Lab-FM-Project/master/Arduino_WebRadio_player/webradio_pic2.jpg

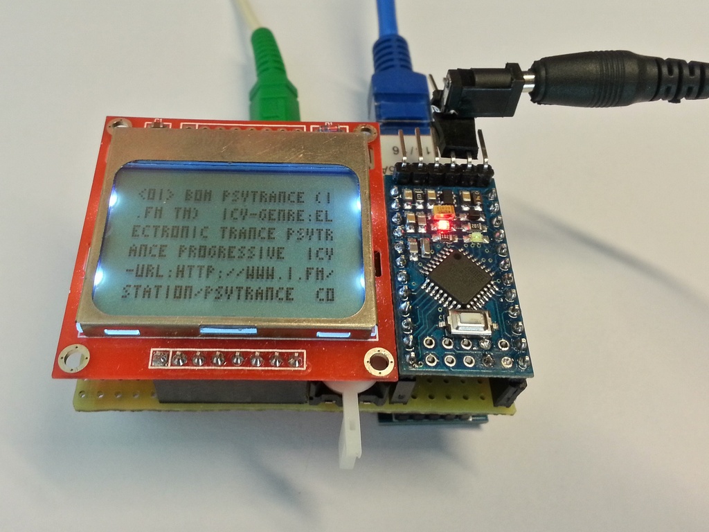
Arduino_WebRadio_player/webradio_pic2.jpg
