Lab-FM-Project/master/Arduino_WebRadio_player/webradio_pic1.jpg

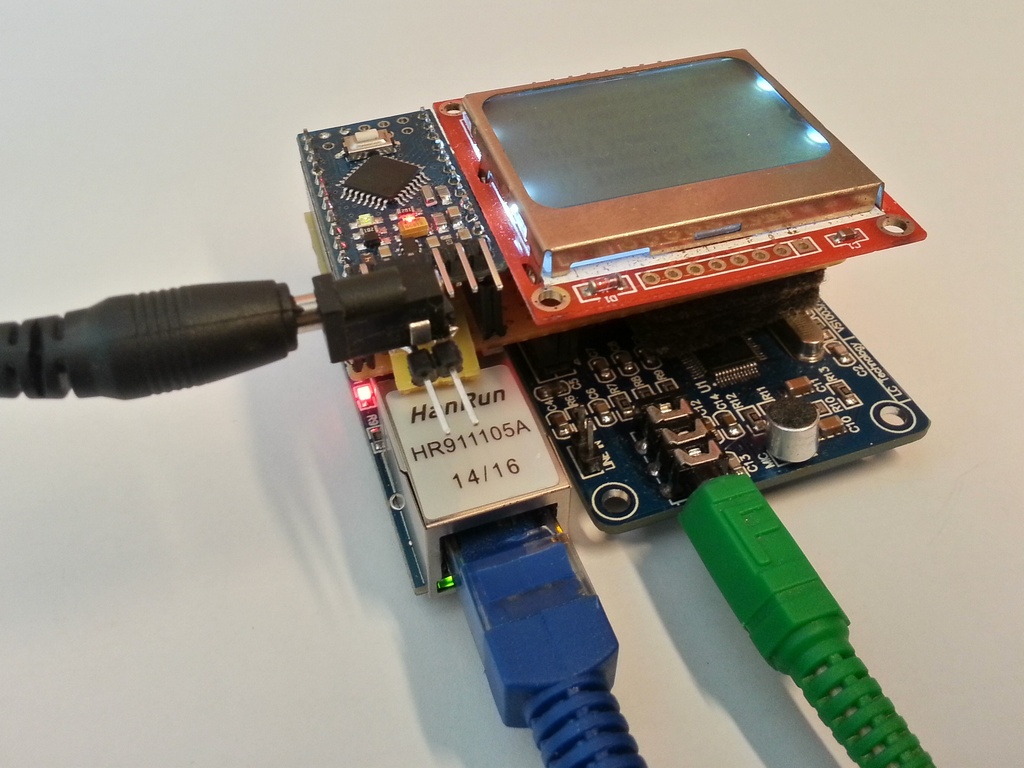
Arduino_WebRadio_player/webradio_pic1.jpg
