Lab-FM-Project/master/README.md

# master
FMProject master folder

Second year FM project. Based on the AR1010 FM chip. We got to play around with it and add any innovations. (Even if its only 10% of the mark!)
