Lab-FM-Project/master/Schematics/Circuit_Schematicv2.html

Partlist exported from /Users/user/Desktop/master/Schematics/Circuit_Schematicv2.sch at 24/03/2017 14:05

Part | Value | Device | Package | Description
3.3V | TPSPAD1-13 | TPSPAD1-13 | P1-13 | TEST PIN
24C64 | 24C64 | 24C64 | SOIC-8
ANT | | 2,15/1,0 | 2,15/1,0 | THROUGH-HOLE PAD
AR_PRG | | PINHD-1X7 | 1X07 | PIN HEADER
AUXJACK | | PINHD-1X5 | 1X05 | PIN HEADER
BAT- | | 2,15/1,0 | 2,15/1,0 | THROUGH-HOLE PAD
BAT_5V | | 2,15/1,0 | 2,15/1,0 | THROUGH-HOLE PAD
C1 | 10uF | 10UF-1210-50V-20% | 1210 | 10.0µF ceramic capacitors
C2 | 100nF | 10UF-1210-50V-20% | 1210 | 10.0µF ceramic capacitors
C3 | 10uF | 10UF-1210-50V-20% | 1210 | 10.0µF ceramic capacitors
C4 | 10uF | 10UF-1210-50V-20% | 1210 | 10.0µF ceramic capacitors
C5 | 10uF | 10UF-1210-50V-20% | 1210 | 10.0µF ceramic capacitors
C6 | 10uF | 10UF-1210-50V-20% | 1210 | 10.0µF ceramic capacitors
C7 | 100uF | 10UF-1210-50V-20% | 1210 | 10.0µF ceramic capacitors
C8 | 100uF | 10UF-1210-50V-20% | 1210 | 10.0µF ceramic capacitors
C9 | 100nF | 10UF-1210-50V-20% | 1210 | 10.0µF ceramic capacitors
C10 | 100nF | 10UF-1210-50V-20% | 1210 | 10.0µF ceramic capacitors
C11 | 10uF | 10UF-1210-50V-20% | 1210 | 10.0µF ceramic capacitors
C12 | 100nF | 10UF-1210-50V-20% | 1210 | 10.0µF ceramic capacitors
CLOCK | TPSPAD1-13 | TPSPAD1-13 | P1-13 | TEST PIN
D1 | BLUE | LED-BLUE1206 | LED-1206 | Blue SMD LED
DATA | TPSPAD1-13 | TPSPAD1-13 | P1-13 | TEST PIN
ESP_PRG | | PINHD-1X3 | 1X03 | PIN HEADER
FAV1 | | NMOSSOT223 | SOT223 | MOS FET
GND | TPSPAD1-13 | TPSPAD1-13 | P1-13 | TEST PIN
INT_PINS | | PINHD-1X2 | 1X02 | PIN HEADER
JP1 | | JP1E | JP1 | JUMPER
JP2 | | LCD16X2HEADER | LCD16X2HEADER | PIN HEADER
JP3 | | JP1E | JP1 | JUMPER
L-OUT | TPSPAD1-13 | TPSPAD1-13 | P1-13 | TEST PIN
MDL1 | | ESP8266-12EESP8266-ESP12E | ESP8266-ESP12E | ESP8266-12E with additional I/O and GPIO04/05 corrected
MUTE | | NMOSSOT223 | SOT223 | MOS FET
NEXT | | NMOSSOT223 | SOT223 | MOS FET
OUT1 | TPSPAD1-13 | TPSPAD1-13 | P1-13 | TEST PIN
PIC_PRG | | PINHD-1X6 | 1X06 | PIN HEADER
PREVIOUS | | NMOSSOT223 | SOT223 | MOS FET
Q2 | LE33CZ | LE33CZ | TO127P254X749-3 | VOLTAGE REGULATORS
R1 | 300 | 1OHM-0603-1/10W-1% | 0603 | 1Ω resistor
R2 | 10k | 10KOHM-0603-1/10W-1% | 0603 | 10kΩ resistor
R3 | 4.7 | 1OHM-0603-1/10W-1% | 0603 | 1Ω resistor
R4 | 4.7 | 1OHM-0603-1/10W-1% | 0603 | 1Ω resistor
R5 | 300 | 1OHM-0603-1/10W-1% | 0603 | 1Ω resistor
R6 | 300 | 1OHM-0603-1/10W-1% | 0603 | 1Ω resistor
R7 | 300 | 1OHM-0603-1/10W-1% | 0603 | 1Ω resistor
R8 | 300 | 1OHM-0603-1/10W-1% | 0603 | 1Ω resistor
R9 | 300 | 1OHM-0603-1/10W-1% | 0603 | 1Ω resistor
R10 | 10k | 10KOHM-0603-1/10W-1% | 0603 | 10kΩ resistor
R11 | 10k | 10KOHM-0603-1/10W-1% | 0603 | 10kΩ resistor
R12 | 10k | 10KOHM-0603-1/10W-1% | 0603 | 10kΩ resistor
R13 | 10k | 10KOHM-0603-1/10W-1% | 0603 | 10kΩ resistor
R14 | 10k | 10KOHM-0603-1/10W-1% | 0603 | 10kΩ resistor
R15 | 4.7k | 1OHM-0603-1/10W-1% | 0603 | 1Ω resistor
R16 | 10k | 10KOHM-0603-1/10W-1% | 0603 | 10kΩ resistor
R17 | 10k | 10KOHM-0603-1/10W-1% | 0603 | 10kΩ resistor
R18 | 4.7k | 1OHM-0603-1/10W-1% | 0603 | 1Ω resistor
S3 | RESET ESP | MOMENTARY-SWITCH-SPST-SMD-6.0X3.5MM | TACTILE_SWITCH_SMD_6.0X3.5MM | Momentary Switch (Pushbutton) - SPST
S4 | FAV1 | MOMENTARY-SWITCH-SPST-PTH-6.0MM-KIT | TACTILE_SWITCH_PTH_6.0MM_KIT | Momentary Switch (Pushbutton) - SPST
S5 | FAV2 | MOMENTARY-SWITCH-SPST-PTH-6.0MM-KIT | TACTILE_SWITCH_PTH_6.0MM_KIT | Momentary Switch (Pushbutton) - SPST
S6 | FAV3 | MOMENTARY-SWITCH-SPST-PTH-6.0MM-KIT | TACTILE_SWITCH_PTH_6.0MM_KIT | Momentary Switch (Pushbutton) - SPST
S7 | NEXT | MOMENTARY-SWITCH-SPST-PTH-6.0MM-KIT | TACTILE_SWITCH_PTH_6.0MM_KIT | Momentary Switch (Pushbutton) - SPST
S8 | PREVIOUS | MOMENTARY-SWITCH-SPST-PTH-6.0MM-KIT | TACTILE_SWITCH_PTH_6.0MM_KIT | Momentary Switch (Pushbutton) - SPST
S9 | VOLUP | MOMENTARY-SWITCH-SPST-PTH-6.0MM-KIT | TACTILE_SWITCH_PTH_6.0MM_KIT | Momentary Switch (Pushbutton) - SPST
S10 | VOLDOWN | MOMENTARY-SWITCH-SPST-PTH-6.0MM-KIT | TACTILE_SWITCH_PTH_6.0MM_KIT | Momentary Switch (Pushbutton) - SPST
S11 | MUTE | MOMENTARY-SWITCH-SPST-PTH-6.0MM-KIT | TACTILE_SWITCH_PTH_6.0MM_KIT | Momentary Switch (Pushbutton) - SPST
SPARE | | PINHD-1X8 | 1X08 | PIN HEADER
SWITCH1 | | 2,15/1,0 | 2,15/1,0 | THROUGH-HOLE PAD
SWITCH2 | | 2,15/1,0 | 2,15/1,0 | THROUGH-HOLE PAD
T7 | | NMOSSOT223 | SOT223 | MOS FET
U$1 | PIC18F6490-I/PT | PIC18F6490-I/PT | QFP50P1200X1200X120-64N | IC PIC MCU
U$2 | TDA2822M | TDA2822M | TDA2822M
U$4 | AR1010 | AR1010 | AR1010
VOLDOWN | | NMOSSOT223 | SOT223 | MOS FET
VOLUP | | NMOSSOT223 | SOT223 | MOS FET
VR1 | 10k | TRIMPOT-SMD-3MM-OPEN-1/10W-25% | TRIMPOT-SMD-TC33X | Trimming Potentiometer (Trimpot)
VR3 | 10k | TRIMPOT-SMD-3MM-OPEN-1/10W-25% | TRIMPOT-SMD-TC33X | Trimming Potentiometer (Trimpot)
VR4 | 4.7k | TRIMPOT-SMD-3MM-OPEN-1/10W-25% | TRIMPOT-SMD-TC33X | Trimming Potentiometer (Trimpot)
VR5 | 4.7k | TRIMPOT-SMD-3MM-OPEN-1/10W-25% | TRIMPOT-SMD-TC33X | Trimming Potentiometer (Trimpot)
