Lab-FM-Project/master/Arduino_WebRadio_player/WebRadio_schematic.GIF

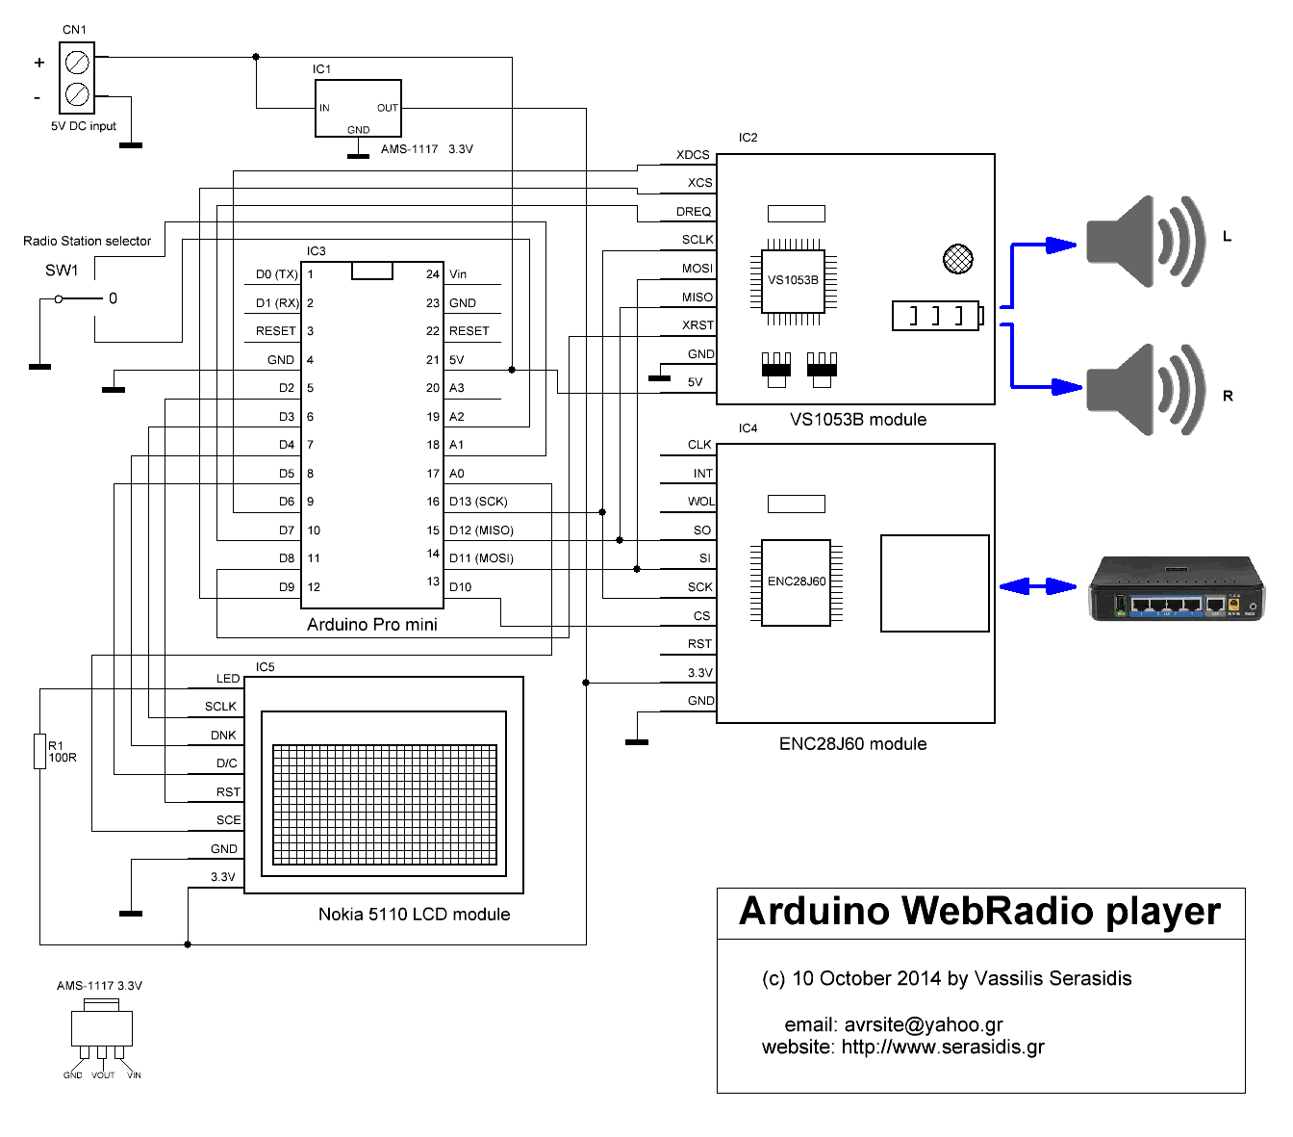
Arduino_WebRadio_player/WebRadio_schematic.GIF
