Lab-FM-Project/master/Schematics/amp&output.png

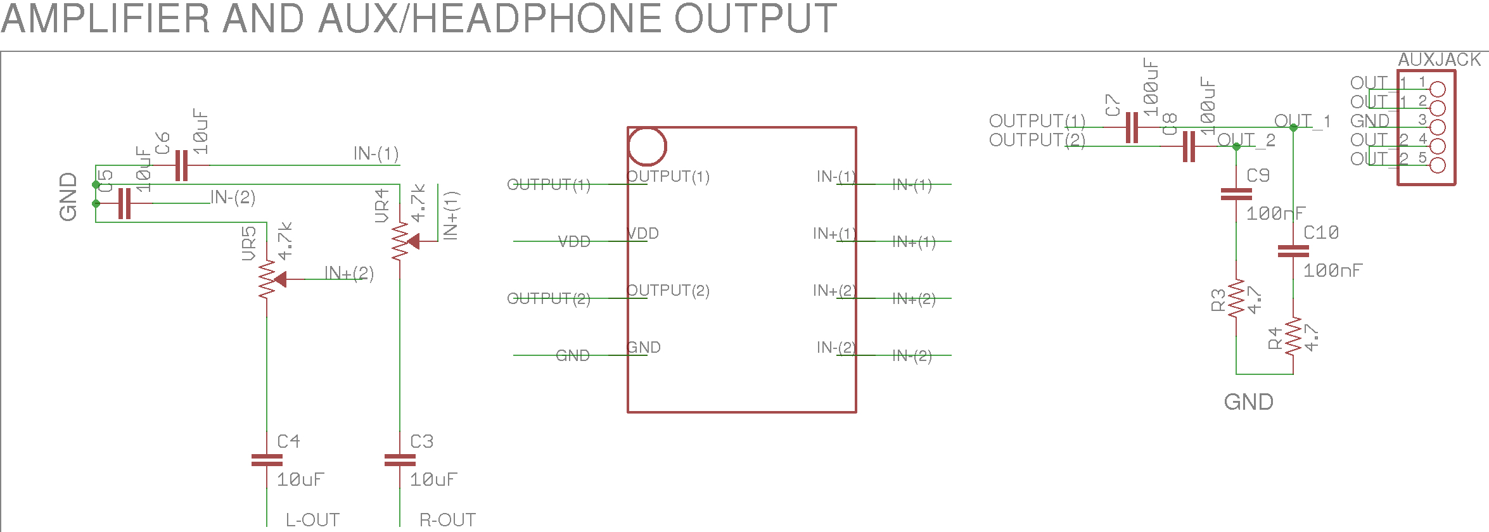
Schematics/amp&output.png
