Lab-FM-Project/master/Schematics/ar1010.png

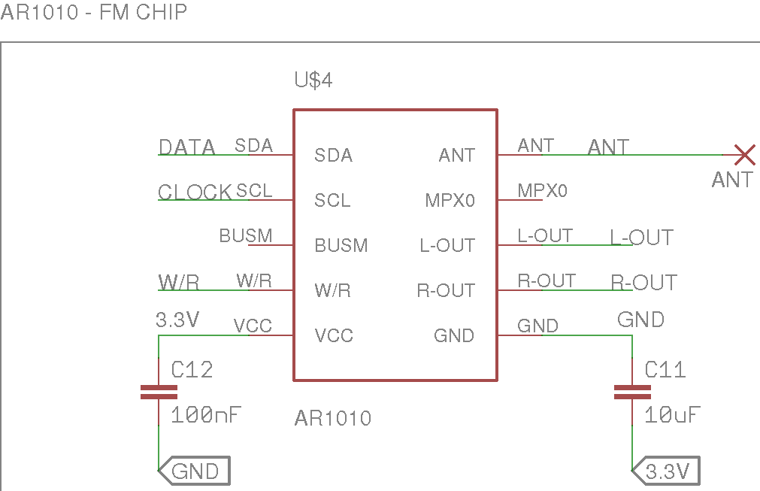
Schematics/ar1010.png
