Lab-FM-Project/master/Schematics/Basic_FM_Receiver_Schematic.png

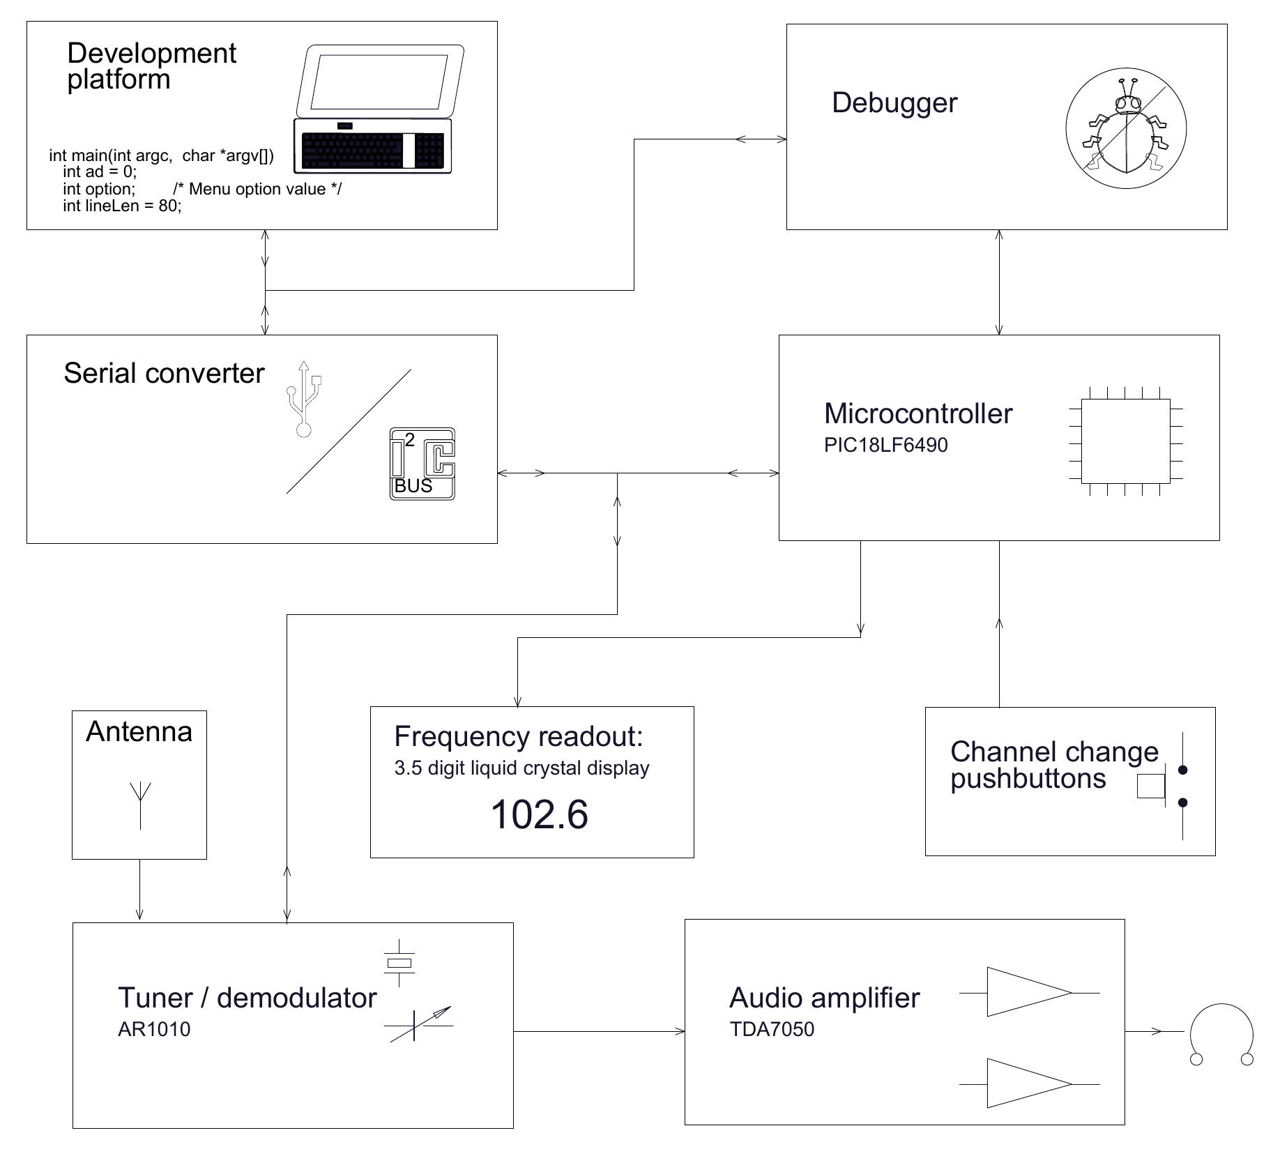
Schematics/Basic_FM_Receiver_Schematic.png
