Lab-FM-Project/master/Schematics/display.png

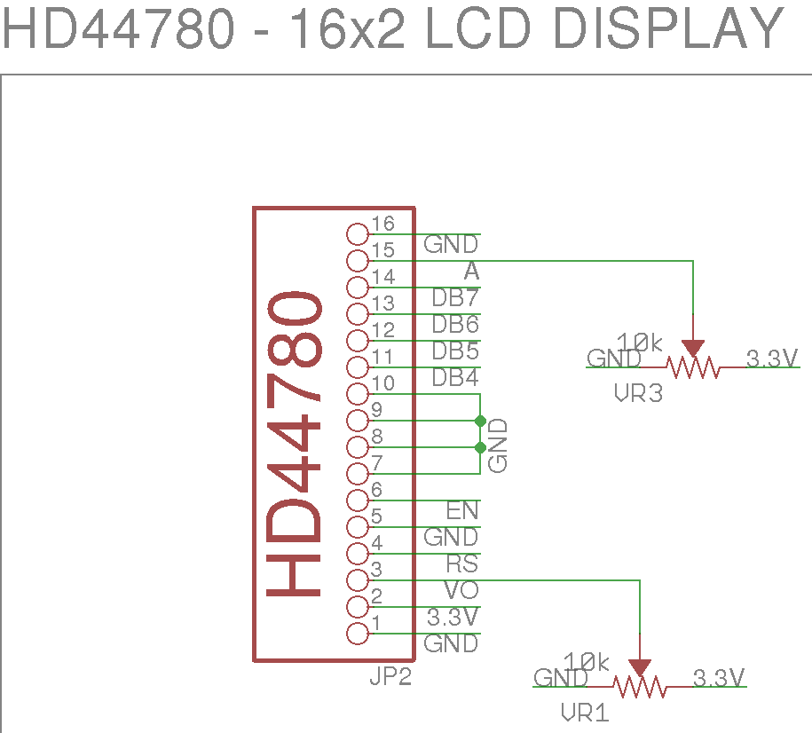
Schematics/display.png
