Lab-FM-Project/master/Schematics/eeprom.png

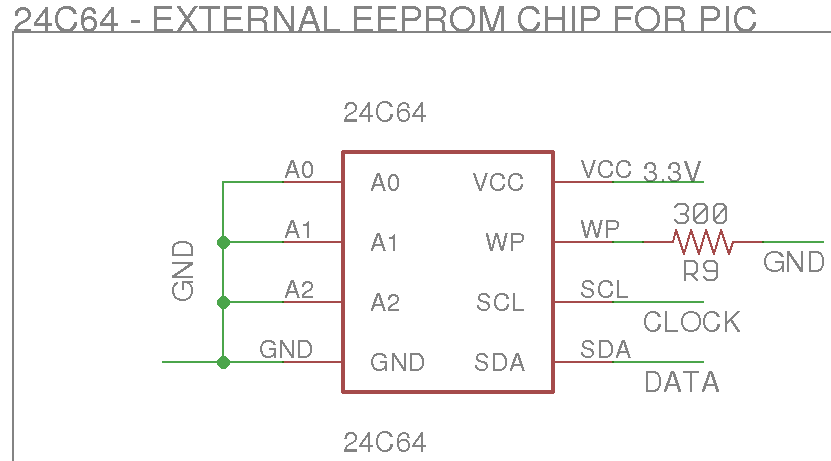
Schematics/eeprom.png
