Lab-FM-Project/master/Schematics/esp.png

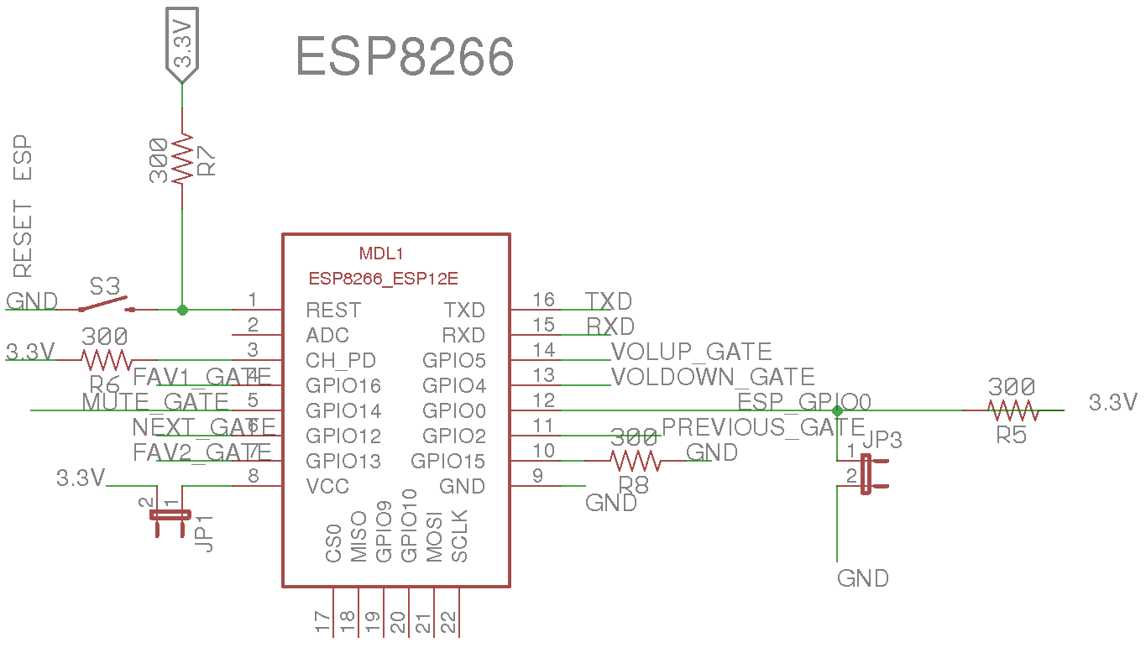
Schematics/esp.png
