Lab-FM-Project/master/Schematics/Final_PCB_Image.png

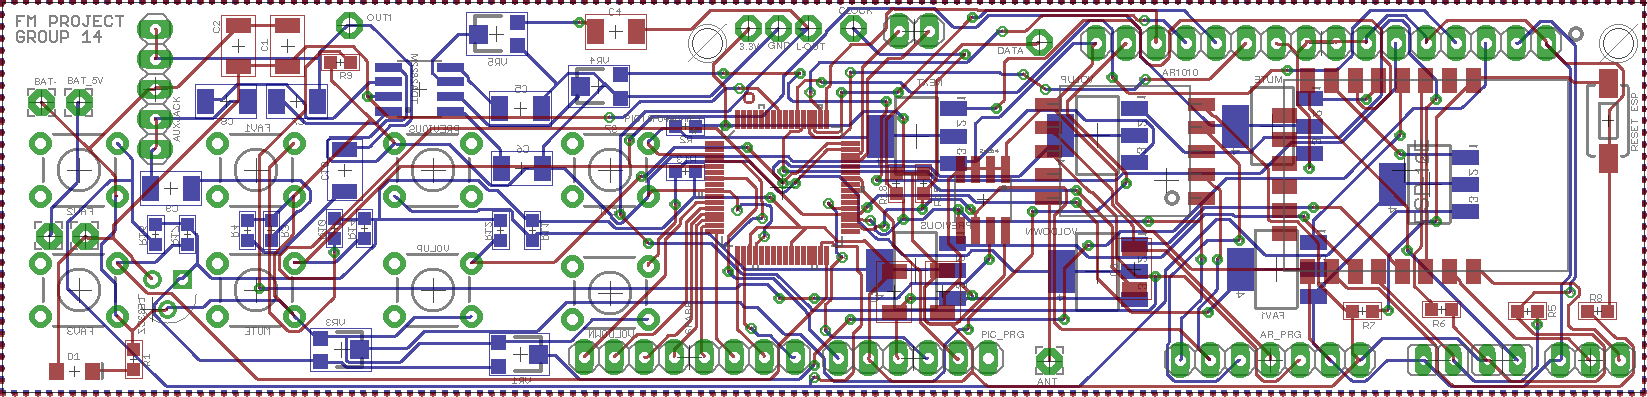
Schematics/Final_PCB_Image.png
