Lab-FM-Project/master/Schematics/Final_Schematic_Image.png

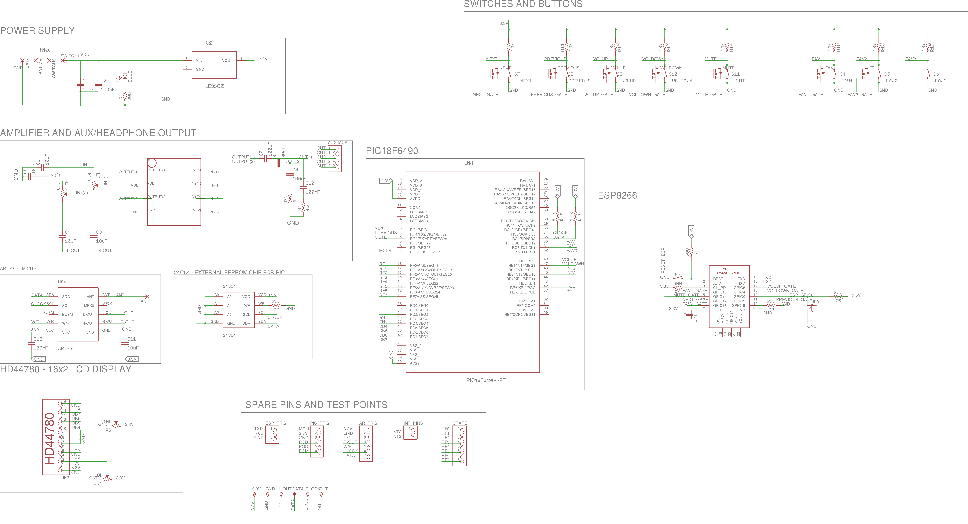
Schematics/Final_Schematic_Image.png
