Lab-FM-Project/master/Schematics/pic.png

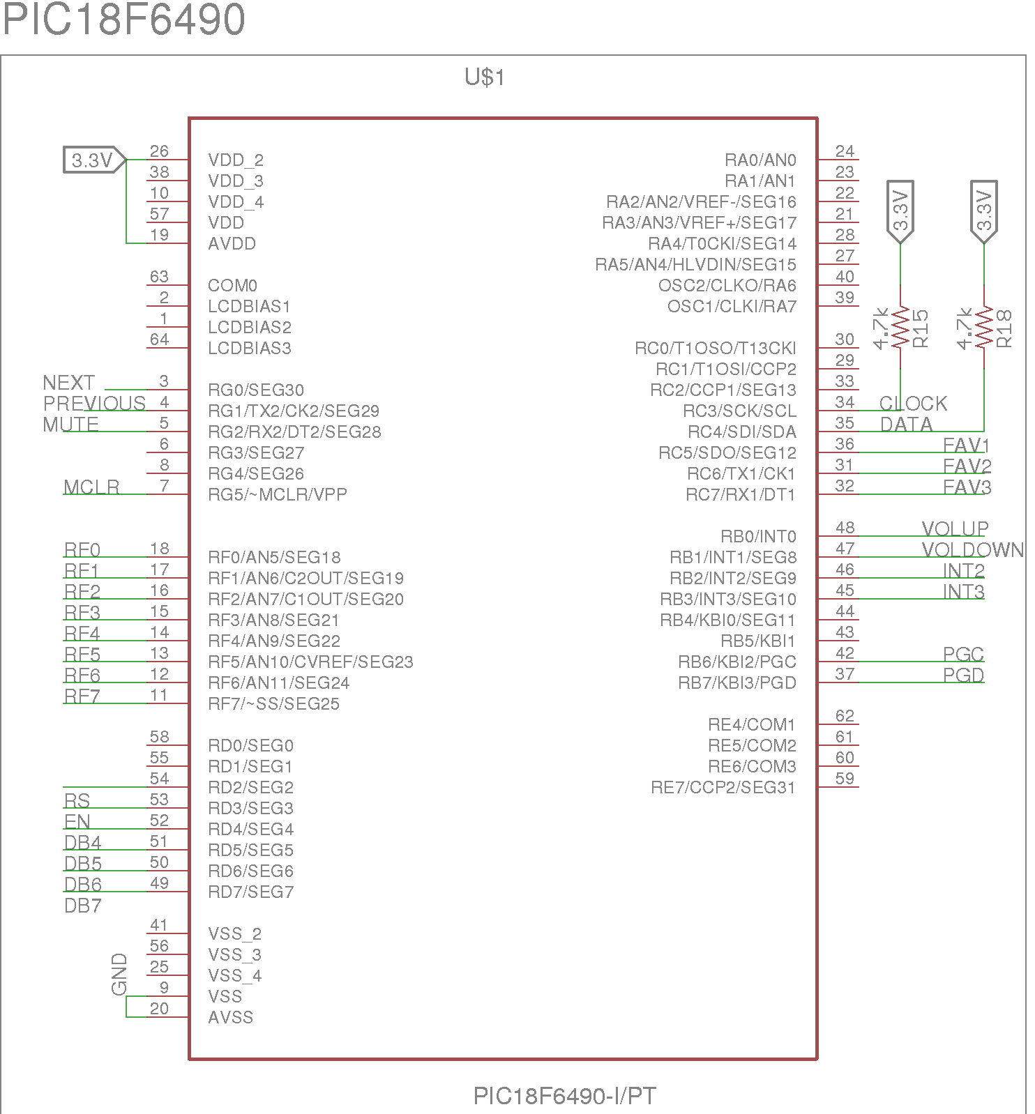
Schematics/pic.png
