Lab-FM-Project/master/Schematics/power_supply.png

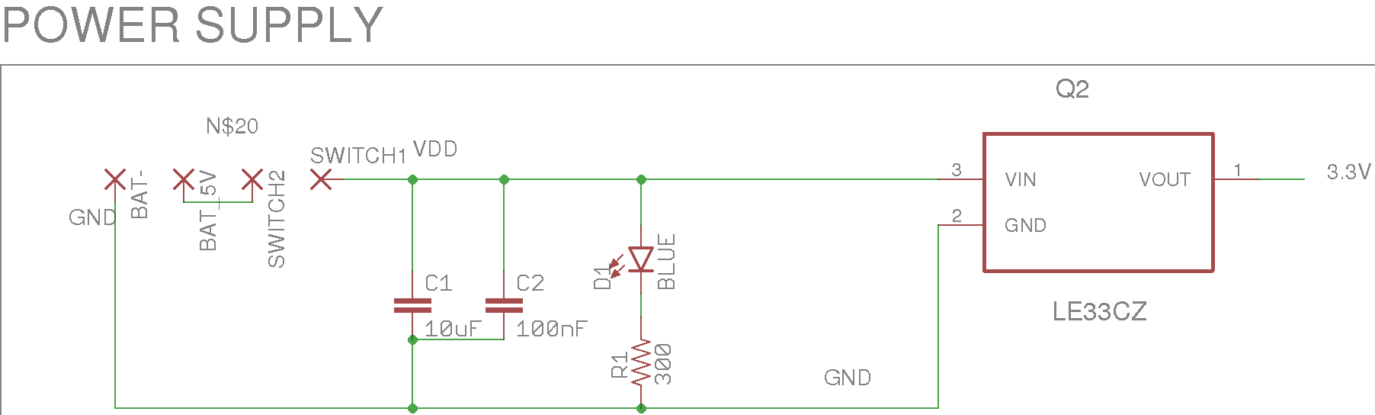
Schematics/power_supply.png
