Lab-FM-Project/master/Schematics/SchematicV0-2_14th-Feb.png

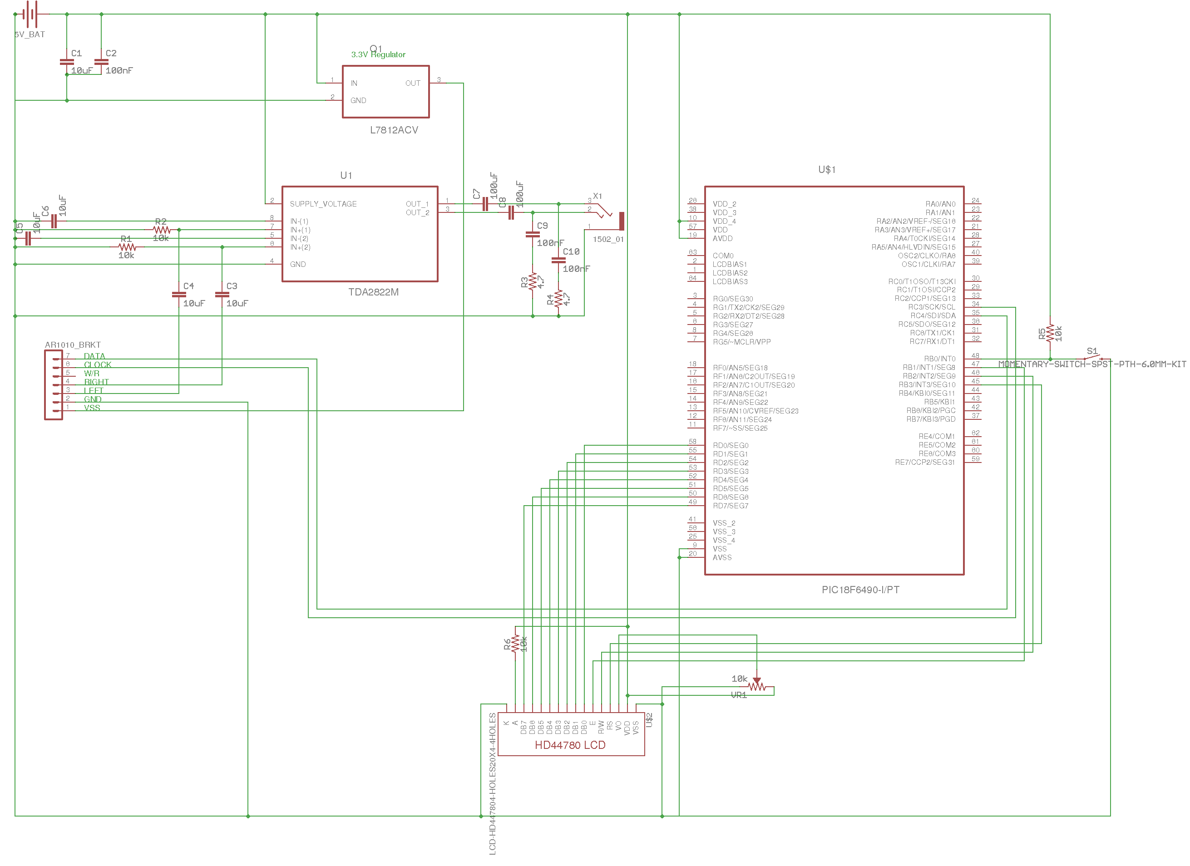
Schematics/SchematicV0-2_14th-Feb.png
