Lab-FM-Project/master/Schematics/switches_buttons.png

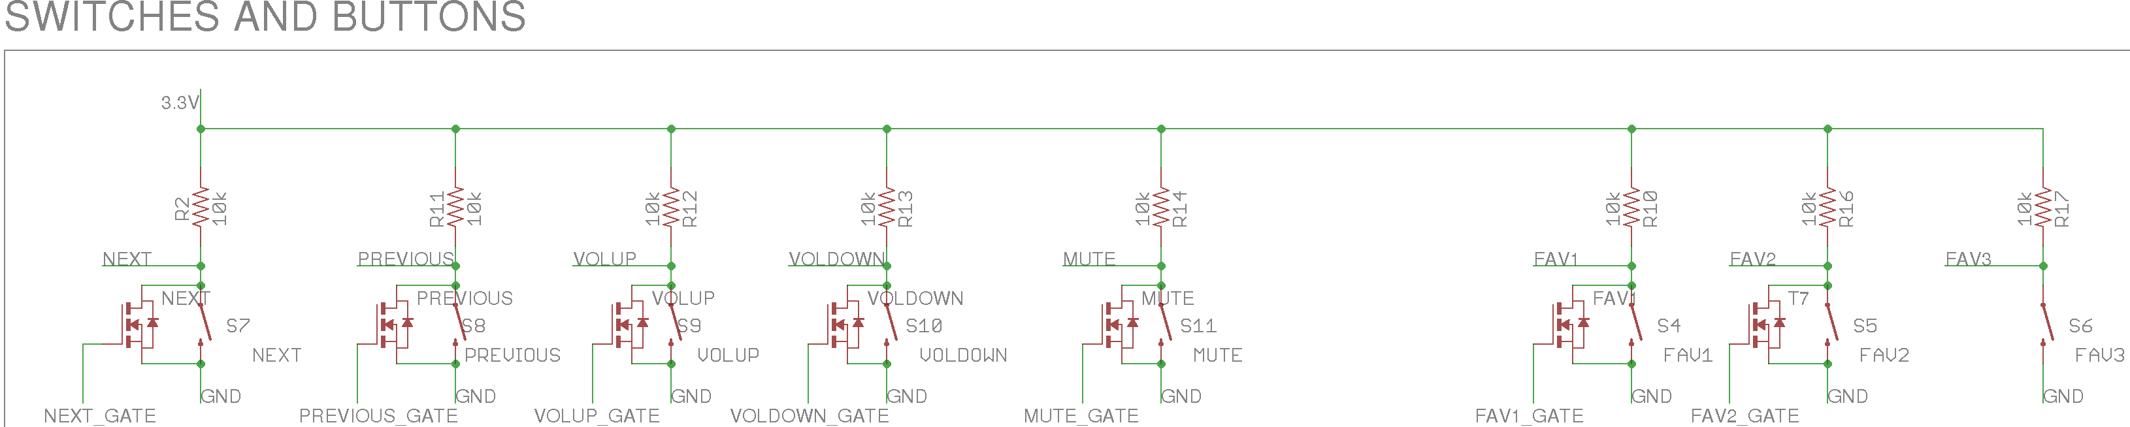
Schematics/switches_buttons.png
