Lab-FM-Project/master/Box files/main chasis.stl

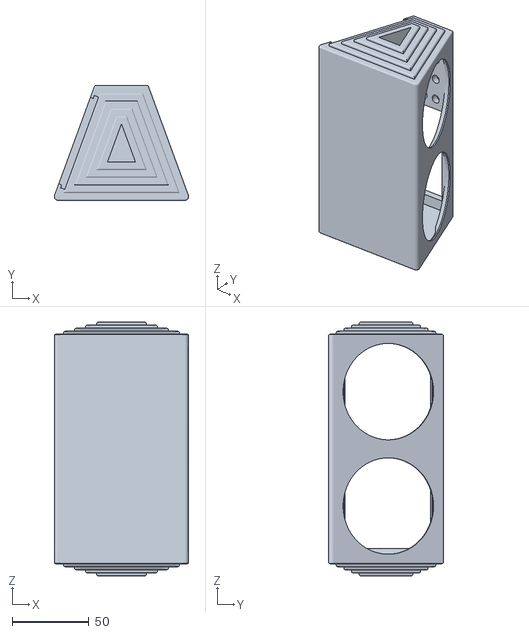
[picture p16: CAD file, 2017-02-28]
Box files/main chasis.stl
87.8 x 75.1 x 166.0
