Lab-FM-Project/master/Box files/FMBOXCHASIS.stl

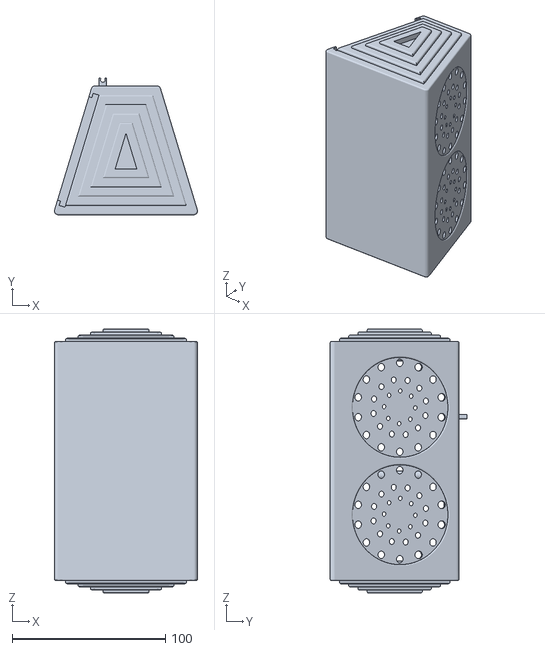
[picture p17: CAD file, 2017-03-03]
Box files/FMBOXCHASIS.stl
93.3 x 89.0 x 172.0
