Lab-FM-Project/master/Box files/fusion_to_PCB.dxf

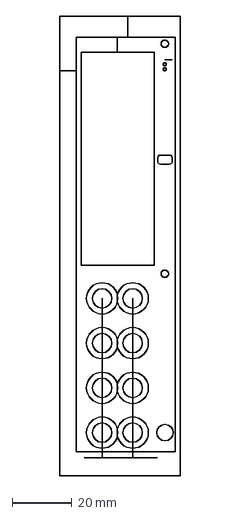
[picture p18: CAD file, 2017-03-03]
Box files/fusion_to_PCB.dxf
40.3 x 154.0 mm
