Lab-FM-Project/master/Box files/FMBOXLID.stl

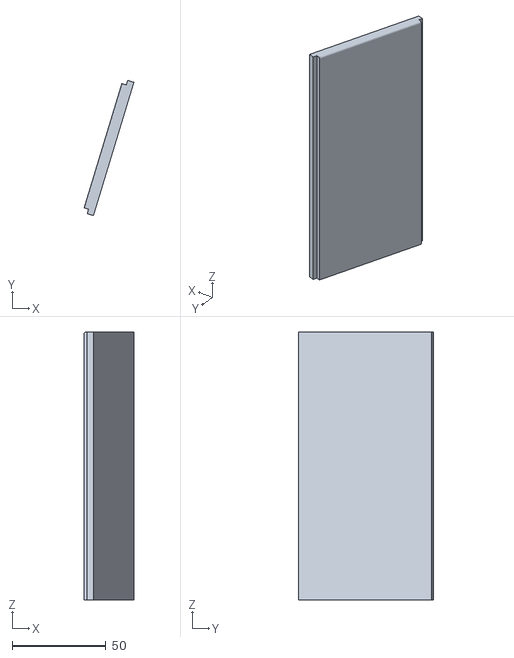
[picture p19: CAD file, 2017-03-03]
Box files/FMBOXLID.stl
26.6 x 72.1 x 143.0
