Lab-FM-Project/master/Box files/1.stl

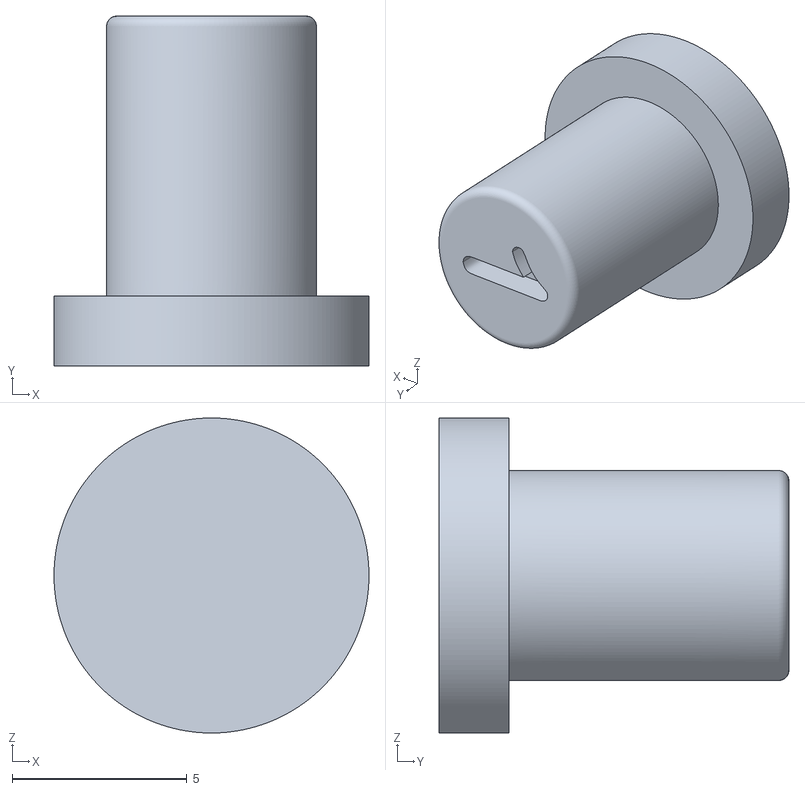
[picture p20: CAD file, 2017-02-28]
Box files/1.stl
9.00 x 10.0 x 9.00
