Lab-FM-Project/master/Box files/lid.stl

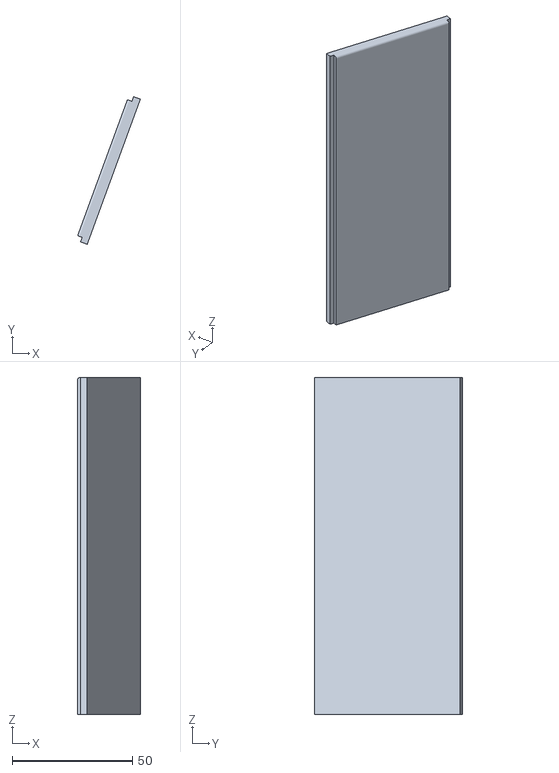
[picture p21: CAD file, 2017-02-28]
Box files/lid.stl
26.1 x 61.3 x 140.0
