Lab-FM-Project/master/Box files/3.stl

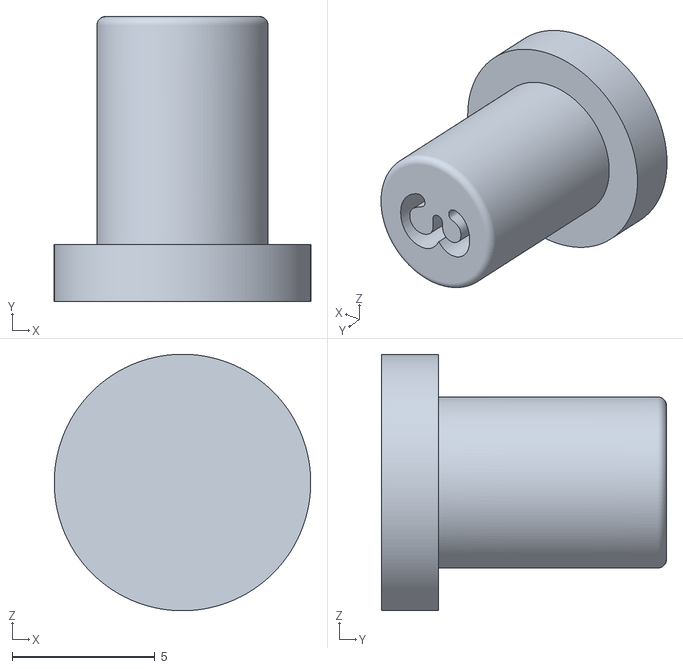
[picture p22: CAD file, 2017-02-28]
Box files/3.stl
9.00 x 10.0 x 9.00
