Lab-FM-Project/master/Box files/on switch.stl

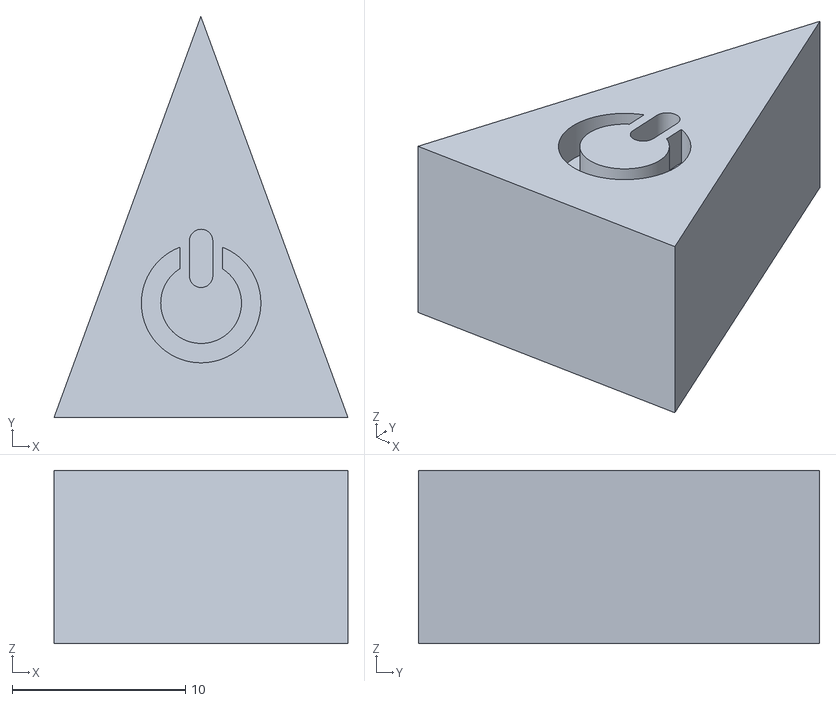
[picture p23: CAD file, 2017-02-28]
Box files/on switch.stl
17.0 x 23.2 x 10.0
