Lab-FM-Project/master/Box files/Prev.stl

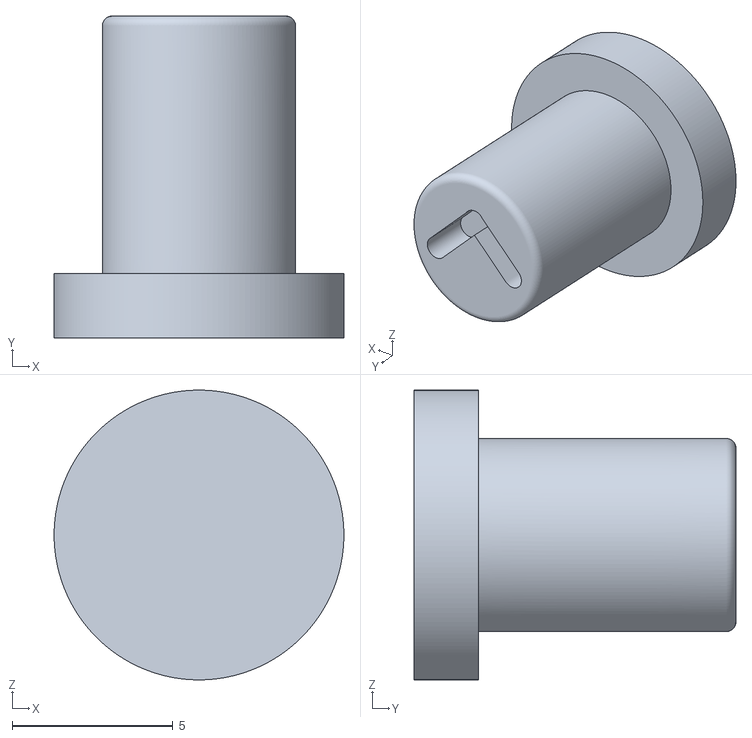
[picture p24: CAD file, 2017-02-28]
Box files/Prev.stl
9.00 x 10.0 x 9.00
