Lab-FM-Project/master/Box files/Vol DN.stl

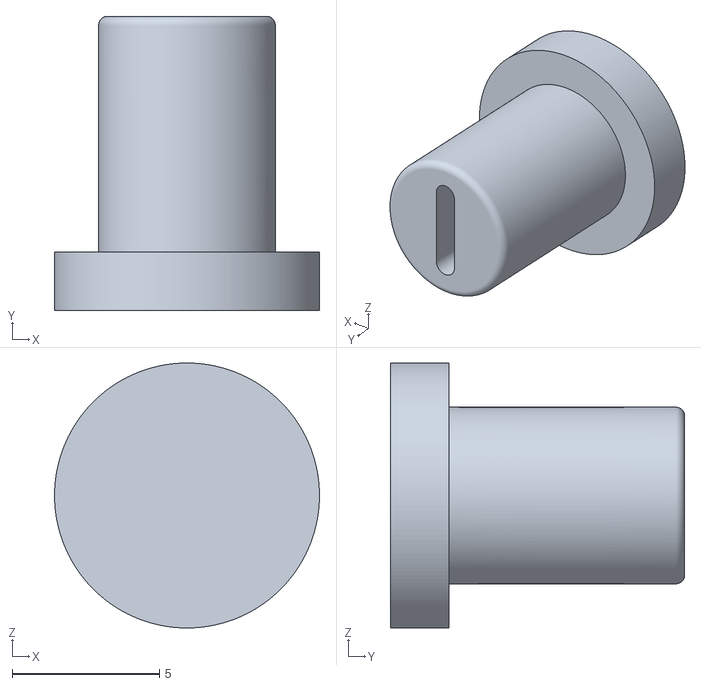
[picture p25: CAD file, 2017-02-28]
Box files/Vol DN.stl
9.00 x 10.0 x 9.00
