Lab-FM-Project/master/(list of files, cad)

Other CAD files:
Box files/Vol UP.stl
Box files/Mute.stl
Box files/Next.stl
Box files/2.stl
Box files/old/Next.stl
Box files/old/2.stl
Box files/old/Mute.stl
Box files/old/Vol UP.stl
