Lab-FM-Project/master/Schematics/spare_pins_test_points.png

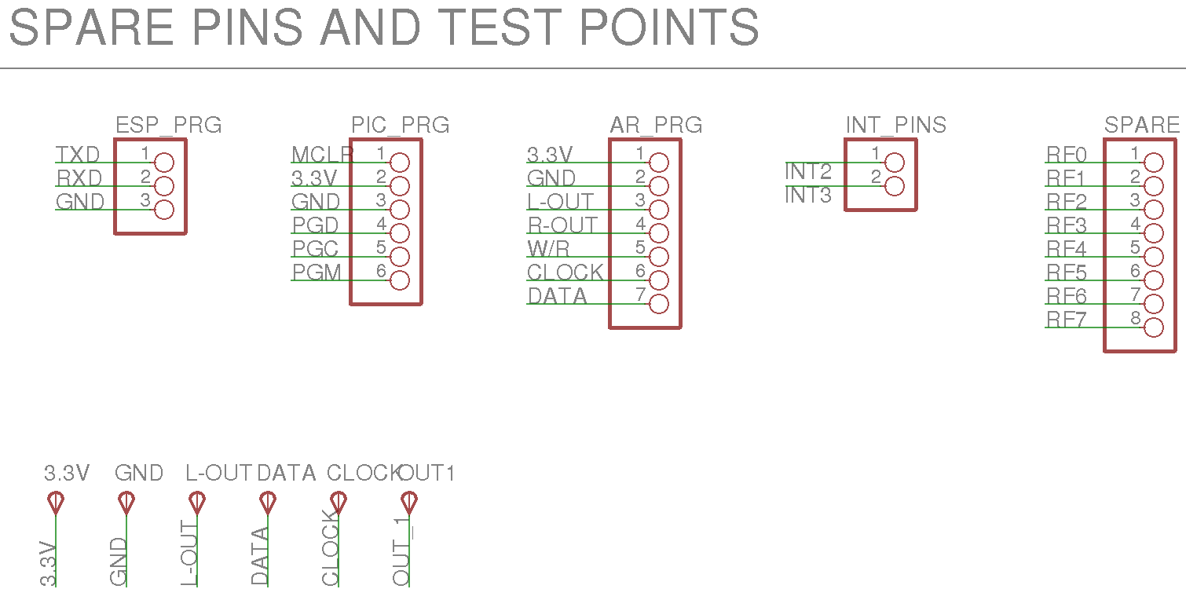
Schematics/spare_pins_test_points.png
