Lab-FM-Project/master/Schematics/Circuit_Schematicv2.brd

## EAGLE design Schematics/Circuit_Schematicv2.brd (2017-03-29)

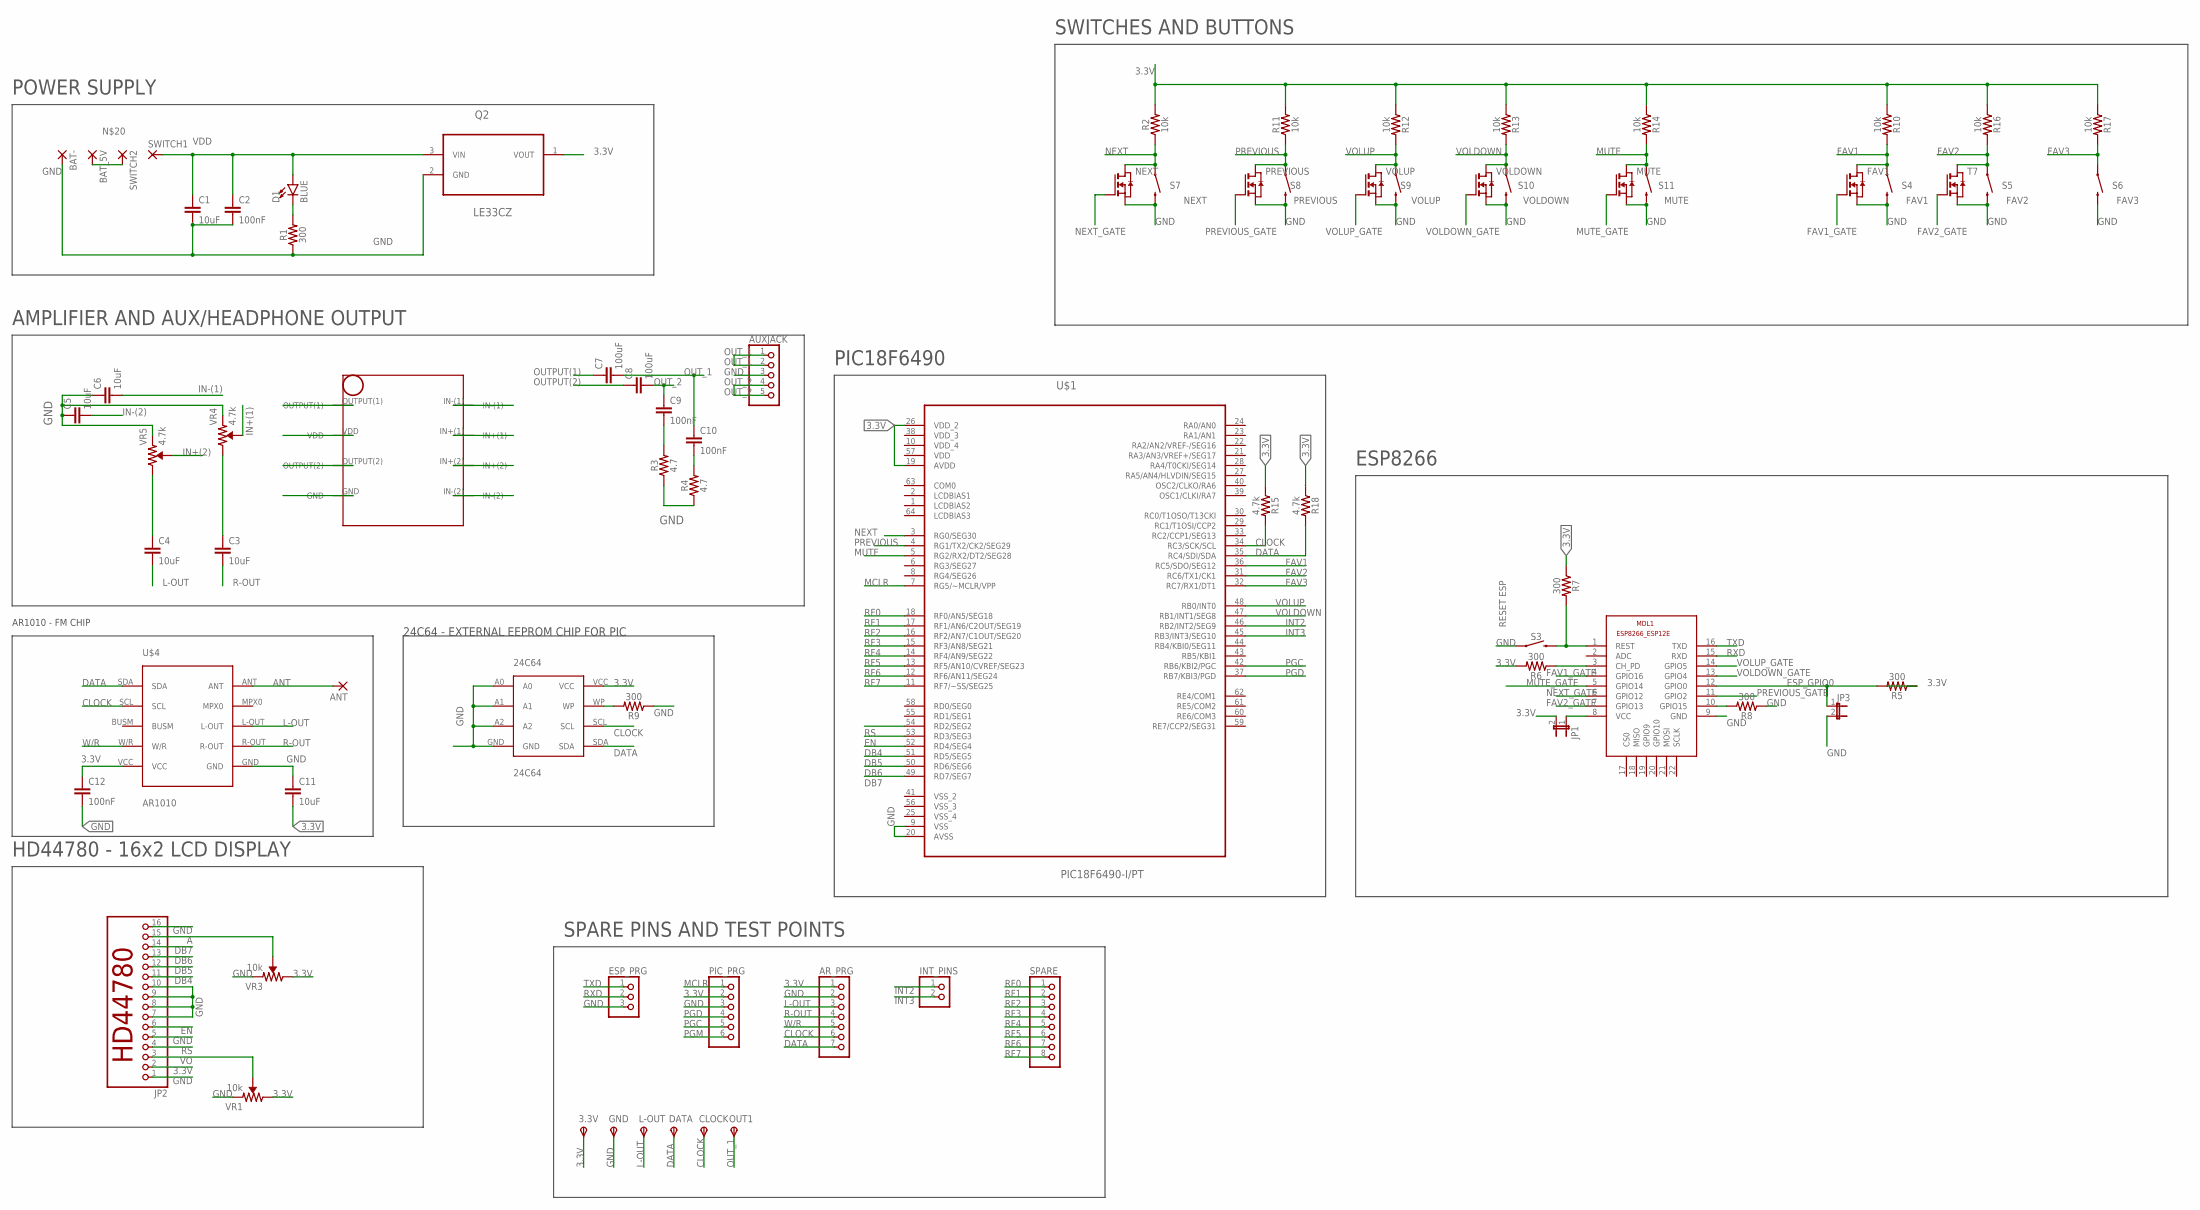
[picture p27: schematic Circuit_Schematicv2.sch]

Parts:
3.3V: TPSPAD1-13; P1-13
24C64: 24C64; SOIC-8
ANT: 2,15/1,0
AR_PRG: PINHD-1X7; 1X07
AUXJACK: PINHD-1X5; 1X05
BAT-: 2,15/1,0
BAT_5V: 2,15/1,0
C1, C3, C4, C5, C6, C11: 10uF; 1210
C2, C9, C10, C12: 100nF; 1210
C7, C8: 100uF; 1210
CLOCK: TPSPAD1-13; P1-13
D1: BLUE; LED-1206
DATA: TPSPAD1-13; P1-13
ESP_PRG: PINHD-1X3; 1X03
FAV1: NMOSSOT223; SOT223
GND: TPSPAD1-13; P1-13
INT_PINS: PINHD-1X2; 1X02
JP1, JP3: JP1E; JP1
JP2: LCD16X2HEADER
L-OUT: TPSPAD1-13; P1-13
MDL1: ESP8266-12EESP8266-ESP12E; ESP8266-ESP12E
MUTE: NMOSSOT223; SOT223
NEXT: NMOSSOT223; SOT223
OUT1: TPSPAD1-13; P1-13
PIC_PRG: PINHD-1X6; 1X06
PREVIOUS: NMOSSOT223; SOT223
Q2: LE33CZ; TO127P254X749-3
R1, R5, R6, R7, R8, R9: 300; 0603
R2, R10, R11, R12, R13, R14, R16, R17: 10k; 0603
R3, R4: 4.7; 0603
R15, R18: 4.7k; 0603
S3: RESET ESP; TACTILE_SWITCH_SMD_6.0X3.5MM
S4: FAV1; TACTILE_SWITCH_PTH_6.0MM_KIT
S5: FAV2; TACTILE_SWITCH_PTH_6.0MM_KIT
S6: FAV3; TACTILE_SWITCH_PTH_6.0MM_KIT
S7: NEXT; TACTILE_SWITCH_PTH_6.0MM_KIT
S8: PREVIOUS; TACTILE_SWITCH_PTH_6.0MM_KIT
S9: VOLUP; TACTILE_SWITCH_PTH_6.0MM_KIT
S10: VOLDOWN; TACTILE_SWITCH_PTH_6.0MM_KIT
S11: MUTE; TACTILE_SWITCH_PTH_6.0MM_KIT
SPARE: PINHD-1X8; 1X08
SWITCH1, SWITCH2: 2,15/1,0
T7: NMOSSOT223; SOT223
U$1: PIC18F6490-I/PT; QFP50P1200X1200X120-64N
U$2: TDA2822M
U$4: AR1010
VOLDOWN: NMOSSOT223; SOT223
VOLUP: NMOSSOT223; SOT223
VR1, VR3: 10k; TRIMPOT-SMD-TC33X
VR4, VR5: 4.7k; TRIMPOT-SMD-TC33X

Connections:
3.3V: 3.3V.TP, 24C64.VCC, AR_PRG.1, C11.2, C12.1, JP1.2, JP2.2, PIC_PRG.2, Q2.1 (VOUT), R2.2, R5.1, R6.2, R7.1, R10.1, R11.2, R12.1, R13.1, R14.1, R15.1, R16.1, R17.1, R18.1, U$1.19 (AVDD), U$1.26 (VDD_2), U$4.VCC, VR1.1 (CW), VR3.1 (CW)
A: JP2.15, VR3.2 (WIPER)
ANT: ANT.1, U$4.ANT
CH_PD: MDL1.3 (CH_PD), R6.1
CLOCK: 24C64.SCL, AR_PRG.6, CLOCK.TP, R15.2, U$1.34 (RC3/SCK/SCL), U$4.SCL
DATA: 24C64.SDA, AR_PRG.7, DATA.TP, R18.2, U$1.35 (RC4/SDI/SDA), U$4.SDA
DB4: JP2.11, U$1.52 (RD4/SEG4)
DB5: JP2.12, U$1.51 (RD5/SEG5)
DB6: JP2.13, U$1.50 (RD6/SEG6)
DB7: JP2.14, U$1.49 (RD7/SEG7)
EN: JP2.6, U$1.53 (RD3/SEG3)
ESP_GPIO0: JP3.1, MDL1.12 (GPIO0), R5.2
ESP_VCC: JP1.1, MDL1.8 (VCC)
FAV1: FAV1.2 (D), FAV1.4 (D), R10.2, S4.1, U$1.36 (RC5/SDO/SEG12)
FAV1_GATE: FAV1.1 (G), MDL1.4 (GPIO16)
FAV2: R16.2, S5.1, T7.2 (D), T7.4 (D), U$1.31 (RC6/TX1/CK1)
FAV2_GATE: MDL1.7 (GPIO13), T7.1 (G)
FAV3: R17.2, S6.1, U$1.32 (RC7/RX1/DT1)
GND: 24C64.A0, 24C64.A1, 24C64.A2, 24C64.GND, AR_PRG.2, AUXJACK.3, BAT-.1, C1.2, C2.2, C5.1, C6.1, C11.1, C12.2, ESP_PRG.3, FAV1.3 (S), GND.TP, JP2.1, JP2.5, JP2.7, JP2.8, JP2.9, JP2.10, JP2.16, JP3.2, MDL1.9 (GND), MUTE.3 (S), NEXT.3 (S), PIC_PRG.3, PREVIOUS.3 (S), Q2.2 (GND), R1.1, R3.1, R4.1, R8.1, R9.1, S3.1, S4.3 (2), S5.3 (2), S6.3 (2), S7.3 (2), S8.3 (2), S9.3 (2), S10.3 (2), S11.3 (2), T7.3 (S), U$1.9 (VSS), U$1.20 (AVSS), U$2.GND, U$4.GND, VOLDOWN.3 (S), VOLUP.3 (S), VR1.3 (CCW), VR3.3 (CCW), VR4.3 (CCW), VR5.3 (CCW)
IN+(1): U$2.IN+(1), VR4.2 (WIPER)
IN+(2): U$2.IN+(2), VR5.2 (WIPER)
IN-(1): C6.2, U$2.IN-(1)
IN-(2): C5.2, U$2.IN-(2)
INT2: INT_PINS.1, U$1.46 (RB2/INT2/SEG9)
INT3: INT_PINS.2, U$1.45 (RB3/INT3/SEG10)
L-OUT: AR_PRG.3, C4.2, L-OUT.TP, U$4.L-OUT
MCLR: PIC_PRG.1, U$1.7 (RG5/~MCLR/VPP)
MUTE: MUTE.2 (D), MUTE.4 (D), R14.2, S11.1, U$1.5 (RG2/RX2/DT2/SEG28)
MUTE_GATE: MDL1.5 (GPIO14), MUTE.1 (G)
unnamed: C10.2, R4.2
unnamed: 24C64.WP, R9.2
unnamed: C4.1, VR5.1 (CW)
unnamed: C3.1, VR4.1 (CW)
unnamed: C9.2, R3.2
unnamed: D1.C, R1.2
unnamed: BAT_5V.1, SWITCH2.1
unnamed: MDL1.10 (GPIO15), R8.2
NEXT: NEXT.2 (D), NEXT.4 (D), R2.1, S7.1, U$1.3 (RG0/SEG30)
NEXT_GATE: MDL1.6 (GPIO12), NEXT.1 (G)
OUTPUT(1): C7.1, U$2.OUTPUT(1)
OUTPUT(2): C8.1, U$2.OUTPUT(2)
OUT_1: AUXJACK.1, AUXJACK.2, C7.2, C10.1, OUT1.TP
OUT_2: AUXJACK.4, AUXJACK.5, C8.2, C9.1
PGC: PIC_PRG.5, U$1.42 (RB6/KBI2/PGC)
PGD: PIC_PRG.4, U$1.37 (RB7/KBI3/PGD)
PGM: PIC_PRG.6
PREVIOUS: PREVIOUS.2 (D), PREVIOUS.4 (D), R11.1, S8.1, U$1.4 (RG1/TX2/CK2/SEG29)
PREVIOUS_GATE: MDL1.11 (GPIO2), PREVIOUS.1 (G)
R-OUT: AR_PRG.4, C3.2, U$4.R-OUT
REST: MDL1.1 (REST), R7.2, S3.2
RF0: SPARE.1, U$1.18 (RF0/AN5/SEG18)
RF1: SPARE.2, U$1.17 (RF1/AN6/C2OUT/SEG19)
RF2: SPARE.3, U$1.16 (RF2/AN7/C1OUT/SEG20)
RF3: SPARE.4, U$1.15 (RF3/AN8/SEG21)
RF4: SPARE.5, U$1.14 (RF4/AN9/SEG22)
RF5: SPARE.6, U$1.13 (RF5/AN10/CVREF/SEG23)
RF6: SPARE.7, U$1.12 (RF6/AN11/SEG24)
RF7: SPARE.8, U$1.11 (RF7/~SS/SEG25)
RS: JP2.4, U$1.54 (RD2/SEG2)
RXD: ESP_PRG.2, MDL1.15 (RXD)
TXD: ESP_PRG.1, MDL1.16 (TXD)
VDD: C1.1, C2.1, D1.A, Q2.3 (VIN), SWITCH1.1, U$1.57 (VDD), U$2.VDD
VDD_3: U$1.38 (VDD_3)
VDD_4: U$1.10 (VDD_4)
VO: JP2.3, VR1.2 (WIPER)
VOLDOWN: R13.2, S10.1, U$1.47 (RB1/INT1/SEG8), VOLDOWN.2 (D), VOLDOWN.4 (D)
VOLDOWN_GATE: MDL1.13 (GPIO4), VOLDOWN.1 (G)
VOLUP: R12.2, S9.1, U$1.48 (RB0/INT0), VOLUP.2 (D), VOLUP.4 (D)
VOLUP_GATE: MDL1.14 (GPIO5), VOLUP.1 (G)
VSS_2: U$1.41 (VSS_2)
VSS_3: U$1.56 (VSS_3)
VSS_4: U$1.25 (VSS_4)
W/R: AR_PRG.5, U$4.W/R

Notes on the sheet:
POWER SUPPLY
AMPLIFIER AND AUX/HEADPHONE OUTPUT
SWITCHES AND BUTTONS
AR1010 - FM CHIP
HD44780 - 16x2 LCD DISPLAY
ESP8266
24C64 - EXTERNAL EEPROM CHIP FOR PIC
PIC18F6490
SPARE PINS AND TEST POINTS

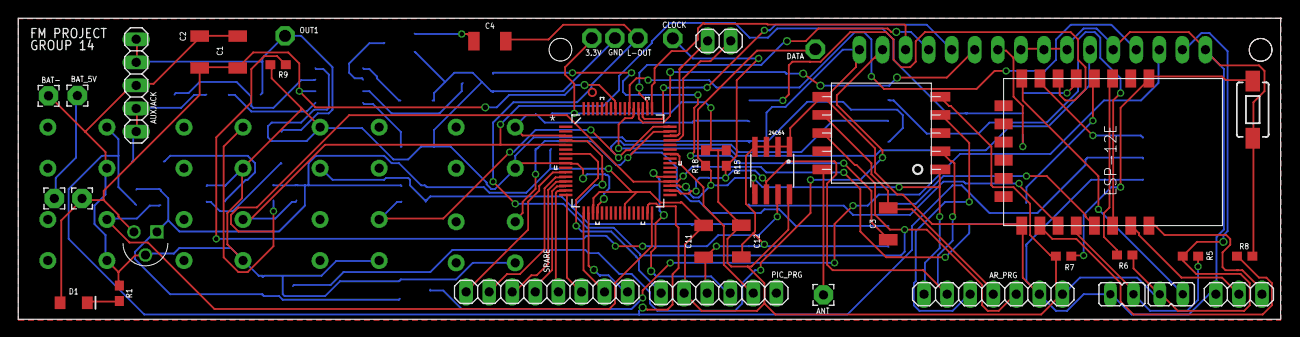
[picture p28: board Circuit_Schematicv2.brd from above]

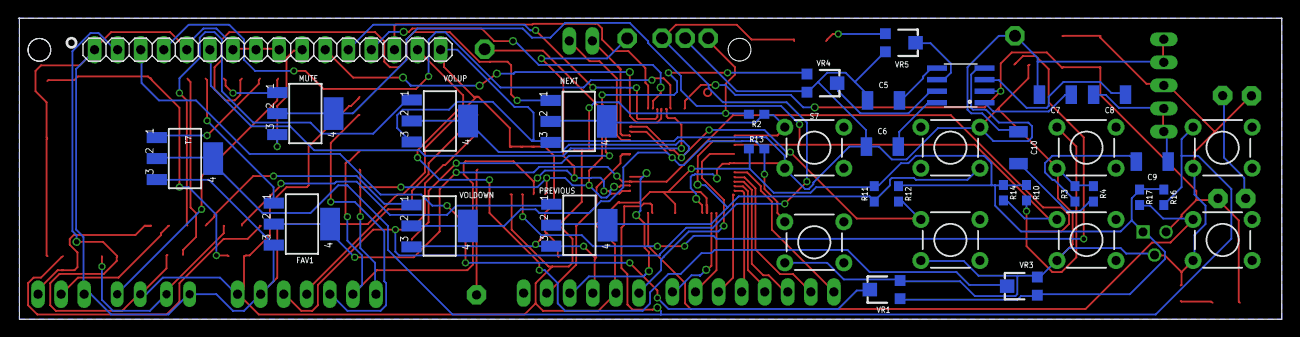
[picture p29: board Circuit_Schematicv2.brd from below]

Board: 2 copper layers, 139.0 x 33.1 mm, 77 parts (37 on the bottom side), 67 nets.
