Lab-FM-Project/master/LCD.X/lcd.h

//LCD Functions Developed by electroSome


void Lcd_Port(char a)
{
	if(a & 1)
		D4 = 1;
	else
		D4 = 0;

	if(a & 2)
		D5 = 1;
	else
		D5 = 0;

	if(a & 4)
		D6 = 1;
	else
		D6 = 0;

	if(a & 8)
		D7 = 1;
	else
		D7 = 0;
}
void Lcd_Cmd(char a)
{
	RS = 0;             // => RS = 0
	Lcd_Port(a);
	EN  = 1;             // => E = 1
        __delay_ms(4);
        EN  = 0;             // => E = 0
}

Lcd_Clear()
{
	Lcd_Cmd(0);
	Lcd_Cmd(1);
}

void Lcd_Set_Cursor(char a, char b)
{
	char temp,z,y;
	if(a == 1)
	{
	  temp = 0x80 + b - 1;
		z = temp>>4;
		y = temp & 0x0F;
		Lcd_Cmd(z);
		Lcd_Cmd(y);
	}
	else if(a == 2)
	{
		temp = 0xC0 + b - 1;
		z = temp>>4;
		y = temp & 0x0F;
		Lcd_Cmd(z);
		Lcd_Cmd(y);
	}
}

void Lcd_Init()
{
  Lcd_Port(0x00);
   __delay_ms(20);
  Lcd_Cmd(0x03);
	__delay_ms(5);
  Lcd_Cmd(0x03);
	__delay_ms(11);
  Lcd_Cmd(0x03);
  /////////////////////////////////////////////////////
  Lcd_Cmd(0x02);
  Lcd_Cmd(0x02);
  Lcd_Cmd(0x08);
  Lcd_Cmd(0x00);
  Lcd_Cmd(0x0C);
  Lcd_Cmd(0x00);
  Lcd_Cmd(0x06);
}

void Lcd_Write_Char(char a)
{
   char temp,y;
   temp = a&0x0F;
   y = a&0xF0;
   RS = 1;             // => RS = 1
   Lcd_Port(y>>4);             //Data transfer
   EN = 1;
   __delay_us(40);
   EN = 0;
   Lcd_Port(temp);
   EN = 1;
   __delay_us(40);
   EN = 0;
}

void Lcd_Write_String(char *a)
{
	int i;
	for(i=0;a[i]!='\0';i++)
	   Lcd_Write_Char(a[i]);
}

void Lcd_Shift_Right()
{
	Lcd_Cmd(0x01);
	Lcd_Cmd(0x0C);
}

void Lcd_Shift_Left()
{
	Lcd_Cmd(0x01);
	Lcd_Cmd(0x08);
}


void homescreen(float freq)
{
	char output[50];
    snprintf(output, 50, "%f", freq);

printf("%s", output);
    Lcd_Clear();
    Lcd_Set_Cursor(1,1);
    Lcd_Write_String(c);
    
    Lcd_Set_Cursor(2,1);
    
   Lcd_Write_String("89.5");
   Lcd_Write_String("MHZ");
}
=======
/**
    Header File for Module lcd.c

  Company:
    Microchip Technology Inc.

  File Name:
    lcd.h

  Summary:
    This file contains the function prototypes for LCD.

  Description:
    This file contains service prototype definition for LCD access on the PicDem 2 Plus demo board.
*/

/*
Copyright (c) 2013 - 2014 released Microchip Technology Inc.  All rights reserved.

Microchip licenses to you the right to use, modify, copy and distribute
Software only when embedded on a Microchip microcontroller or digital signal
controller that is integrated into your product or third party product
(pursuant to the sublicense terms in the accompanying license agreement).

You should refer to the license agreement accompanying this Software for
additional information regarding your rights and obligations.

SOFTWARE AND DOCUMENTATION ARE PROVIDED "AS IS" WITHOUT WARRANTY OF ANY KIND,
EITHER EXPRESS OR IMPLIED, INCLUDING WITHOUT LIMITATION, ANY WARRANTY OF
MERCHANTABILITY, TITLE, NON-INFRINGEMENT AND FITNESS FOR A PARTICULAR PURPOSE.
IN NO EVENT SHALL MICROCHIP OR ITS LICENSORS BE LIABLE OR OBLIGATED UNDER
CONTRACT, NEGLIGENCE, STRICT LIABILITY, CONTRIBUTION, BREACH OF WARRANTY, OR
OTHER LEGAL EQUITABLE THEORY ANY DIRECT OR INDIRECT DAMAGES OR EXPENSES
INCLUDING BUT NOT LIMITED TO ANY INCIDENTAL, SPECIAL, INDIRECT, PUNITIVE OR
CONSEQUENTIAL DAMAGES, LOST PROFITS OR LOST DATA, COST OF PROCUREMENT OF
SUBSTITUTE GOODS, TECHNOLOGY, SERVICES, OR ANY CLAIMS BY THIRD PARTIES
(INCLUDING BUT NOT LIMITED TO ANY DEFENSE THEREOF), OR OTHER SIMILAR COSTS.
*/

#ifndef _LCD_XC_H
#define	_LCD_XC_H

/**
  Section: Included Files
*/


#ifdef	__cplusplus
extern "C" {
#endif

/**
 Section: Macro Definitions
*/
// set up the timing for the LCD delays
#define LCD_delay           5     // ~5mS
#define LCD_Startup         15    // ~15mS

// Command set for Hitachi 44780U LCD display controller
#define LCD_CLEAR           0x01
#define LCD_HOME            0x02
#define LCD_CURSOR_BACK     0x10
#define LCD_CURSOR_FWD      0x14
#define LCD_PAN_LEFT        0x18
#define LCD_PAN_RIGHT       0x1C
#define LCD_CURSOR_OFF      0x0C
#define LCD_CURSOR_ON       0x0E
#define LCD_CURSOR_BLINK    0x0F
#define LCD_CURSOR_LINE2    0xC0

// display controller setup commands from page 46 of Hitachi datasheet
#define FUNCTION_SET        0x28                         // 4 bit interface, 2 lines, 5x8 font
#define ENTRY_MODE          0x06                         // increment mode
#define DISPLAY_SETUP       0x0C                         // display on, cursor off, blink offd

#define LCDLine1()          LCDPutCmd(LCD_HOME)          // legacy support
#define LCDLine2()          LCDPutCmd(LCD_CURSOR_LINE2)  // legacy support
#define shift_cursor()      LCDPutCmd(LCD_CURSOR_FWD)    // legacy support
#define cursor_on()         LCDPutCmd(LCD_CURSOR_ON)     // legacy support
#define DisplayClr()        LCDPutCmd(LCD_CLEAR)         // Legacy support


//----------------------------------------------------------------------
// Definitions specific to the PICDEM 2 Plus
// These apply to the Black (2011) version.
//----------------------------------------------------------------------

// single bit for selecting command register or data register
#define instr        0
#define data         1

// These #defines create the pin connections to the LCD in case they are changed on a future demo board
#define LCD_PORT     PORTD
#define LCD_PWR      PORTDbits.RD7                      // LCD power pin
#define LCD_EN       PORTDbits.RD6                      // LCD enable
#define LCD_RW       PORTDbits.RD5                      // LCD read/write line
#define LCD_RS       PORTDbits.RD4                      // LCD register select line

#define NB_LINES    2                                   // Number of display lines
#define NB_COL      16
#define _XTAL_FREQ 8000000// Number of characters per line

// Function prototypes
/**
  @Summary
    initialize the LCD module

  @Description
    This routine initializes the LCD driver.
    This routine must be called before any other LCD routine is called.

  @Preconditions
    None

  @Param
    None

  @Returns
    None
*/
void LCD_Initialize(void);
 
 /**
  @Summary
    Writes character to LCD at current cursor position

  @Description
    This function displays the specified ASCII character at current position on the LCD

  @Preconditions
    None

  @Param
    ASCII character to be displayed

  @Returns
    None
*/
void LCDPutChar(int ch);

/**
  @Summary
    send an ASCII command to the LCD in instruction mode

  @Description
    This routine writes character to LCD command register

  @Preconditions
    None

  @Param
    ASCII command 

  @Returns
    None
*/
void LCDPutCmd(int ch);

/**
  @Summary
    display a string

  @Description
    This routine writes string to LCD at current cursor position

  @Preconditions
    None

  @Param
    Pointer to string

  @Returns
    None
*/
void LCDPutStr(const char *);                         

/**
  @Summary
    Fuction to write a nibble

  @Description
    This function writes the specified nibble to the LCD.

  @Preconditions
    None

  @Param
    data byte to be written to display

  @Returns
    None
*/
void LCDWriteNibble(int ch, int rs);

/**
  @Summary
    Initialization routine that takes inputs from the EUSART GUI.

  @Description
    This function positions the cursor at the specified Line and column.

  @Preconditions
    None

  @Param
    Column and line at which the cursor should be positioned at

  @Returns
    None

  @Comment
      0 <= pos <= 15
      0 <= ln <= 1
*/
void LCDGoto(int pos, int ln);

void LCD_Initialize()
{
// clear latches before enabling TRIS bits
LCD_PORT = 0;

TRISD = 0x00;

// power up the LCD
LCD_PWR = 1;

// required by display controller to allow power to stabilize
__delay_ms(LCD_Startup);

    // required by display initialization
    LCDPutCmd(0x32);

    // set interface size, # of lines and font
    LCDPutCmd(FUNCTION_SET);

    // turn on display and sets up cursor
    LCDPutCmd(DISPLAY_SETUP);
    
    DisplayClr();

    // set cursor movement direction
    LCDPutCmd(ENTRY_MODE);

}


void LCDWriteNibble(int ch, int rs)
{
    // always send the upper nibble
    ch = (ch >> 4);

    // mask off the nibble to be transmitted
    ch = (ch & 0x0F);

    // clear the lower half of LCD_PORT
    LCD_PORT = (LCD_PORT & 0xF0);

    // move the nibble onto LCD_PORT
    LCD_PORT = (LCD_PORT | ch);

    // set data/instr bit to 0 = insructions; 1 = data
    LCD_RS = rs;

    // RW - set write mode
    LCD_RW = 0;

    // set up enable before writing nibble
    LCD_EN = 1;

    // turn off enable after write of nibble
    LCD_EN = 0;
}

void LCDPutChar(int ch)
{
    __delay_ms(LCD_delay);

    //Send higher nibble first
    LCDWriteNibble(ch,data);

    //get the lower nibble
    ch = (ch << 4);

    // Now send the low nibble
    LCDWriteNibble(ch,data);
}

    
void LCDPutCmd(int ch)
{
    __delay_ms(LCD_delay);

    //Send the higher nibble
    LCDWriteNibble(ch,instr);

    //get the lower nibble
    ch = (ch << 4);

    __delay_ms(1);

    //Now send the lower nibble
    LCDWriteNibble(ch,instr);
}

 
void LCDPutStr(const char *str)
{
    int i=0;
    
    // While string has not been fully traveresed
    while (str[i])
    {
        // Go display current char
        LCDPutChar(str[i++]);
    }
    
}

void LCDGoto(int pos,int ln)
{
    // if incorrect line or column
    if ((ln > (NB_LINES-1)) || (pos > (NB_COL-1)))
    {
        // Just do nothing
        return;
    }

    // LCD_Goto command
    LCDPutCmd((ln == 1) ? (0xC0 | pos) : (0x80 | pos));

    // Wait for the LCD to finish
    __delay_ms(LCD_delay);
}
/**
 End of File
*/

    
#ifdef	__cplusplus
}
#endif

#endif	/* _LCD_XC_H */
