Lab-FM-Project/master/ESP8266/wifiTest/wifiTest.ino

#include <ESP8266WiFiMulti.h>
#include <ESP8266WiFiScan.h>
#include <ESP8266WiFiType.h>
#include <ESP8266WiFiGeneric.h>
#include <ESP8266WiFi.h>
#include <WiFiClientSecure.h>
#include <WiFiClient.h>
#include <WiFiUdp.h>
#include <ESP8266WiFiSTA.h>
#include <WiFiServer.h>
#include <ESP8266WiFiAP.h>
#include <ESP8266WebServer.h>
#include <ESP8266WiFi.h>

const char *ssid = "ESP_Wifi";
const char *password = "password";
ESP8266WebServer server(80);

void handleRoot() {
  server.send(200, "text/html", "<h1>You are connected</h1>");
}

void setup() {
  delay(1000);
  Serial.begin(115200);
  Serial.println();
  Serial.print("Configuring access point...");
  WiFi.softAP(ssid, password);
  IPAddress myIP = WiFi.softAPIP();
  Serial.print("AP IP address: ");
  Serial.println(myIP);
  server.on("/", handleRoot);
  server.begin();
  Serial.println("HTTP server started");
}

void loop() {
  server.handleClient();
}
