Lab-FM-Project/master/(commit log)

2017-02-16 Buttons
    Added buttons
    [FMProject.X.production.obj]
2017-02-17 Basic Buttons
    Figured that the LCD segments are completely blocking off pretty much
    every single pin that has SEG on it when it is initialised in init() :(
    lost a lot of time
    [FMProject.X.production.obj]
2017-02-17 Uploaded circuit schematics thus far
    [Circuit_Schematic.sch]
2017-02-17 Managed to get the buttons working
    [FMProject.X.production.obj]
2017-02-17 Managed to get the FM to work
    [FMProject.X.production.obj]
2017-02-17 Added volume control
    [FMProject.X.production.obj]
2017-02-18 added buttons and cleaned up circuit via net names
2017-02-18 added esp8266-12e and pots for volume adjust on amp
    [Circuit_Schematic.sch]
2017-02-19 SEEK is working!
    Only thing to do is to clean up the code and to add incrementations on
    the frequency and volume.
    Also, hopefully set up the EEPROM
    [FMProject.X.production.obj]
2017-02-19 Started working on seek.
    Hard and soft mute is sorted. Need to replace some regImg for FMRead so
    we can read the current data
    [FMProject.X.production.obj]
2017-02-19 seek function seems to work well
    [FMProject.X.production.obj]
2017-02-19 moved all files to the fm.h
    [FMProject.X.production.obj]
2017-02-19 Fixed the fm.h
    [FMProject.X.production.obj]
2017-02-19 LCD by David Krolik
    [LCD.X.production.obj, l.obj]
2017-02-19 useless changes
    [FMProject.X.production.obj]
2017-02-19 removed lcd
    [LCD.X.production.obj, l.obj]
2017-02-19 added lcd
    [LCD.X.production.obj, l.obj, proteus.DSN]
2017-02-19 Combined folders
    [LCD.X.production.obj, l.obj, proteus.DSN]
2017-02-20 fixed changes
    github is a bit annoying sometimes.
    [main.c]
2017-02-20 recalled the project to a version 2
    Because.
    [FMProject.X.production.obj, l.obj]
2017-02-20 updated schematic to include switch and led
    [Circuit_Schematic.sch]
2017-02-21 cleaned up the code, separated in new h files
    Unfortunately found out that there is no EEPROM on this PIC so we can’t
    use it to store data :( Having an external one for just three variables
    seems a bit of an overkill.
2017-02-21 added proper eagle parts for ram and custom part for DAC
    [Circuit_Schematic.sch]
2017-02-23 Added EEPROM Chip 24C64
    [Circuit_Schematic.sch]
2017-02-24 Added ESP controls via NMOS transistors. Lil bit messy.
    [Circuit_Schematic.sch]
2017-02-24 extende esp8266 code to do all four buttons. Haven't decided on pins yet.
2017-02-25 Added AR1010 chip to the schematic, got rid of the breakout for it
    [Circuit_Schematic.sch]
2017-02-26 tidied up schematic a bit
    [Circuit_Schematic.sch]
2017-02-26 inserted new interrupt functions
2017-02-27 cleaned up the schematic
    [Circuit_Schematicv2.sch]
2017-02-27 updated the schematic
    [Circuit_Schematicv2.sch]
2017-02-28 first attempt for 3D print
    [1.stl, 2.stl, 3.stl, Mute.stl, Next.stl, Prev.stl, Vol DN.stl, Vol UP.stl]
2017-02-28 wired up esp a bit more
2017-03-01 Added EEPROM Chip connections, and finished ESP connections
    We now need to complete it by adding the DAC and RAM chips if we are
    going to use them. Also we should delete the MOSFETs as theyre not
    needed anymore
    [Circuit_Schematicv2.sch]
2017-03-01 added some connectors and cleaned up the code
    [Circuit_Schematicv2.sch]
2017-03-02 added more test pads
    [Circuit_Schematicv2.sch]
2017-03-02 done nothing
    [Circuit_Schematicv2.sch]
2017-03-03 new box design
    [1.stl, 2.stl, 3.stl, FMBOXCHASIS.stl, FMBOXLID.stl, Mute.stl, Next.stl, Prev.stl]
2017-03-03 started creating PCB
    Gonna be tough
    [Circuit_Schematicv2.brd, Circuit_Schematicv2.sch]
2017-03-06 very close to finishing the PCB design. Very tiny!
    [Circuit_Schematicv2.brd, Circuit_Schematicv2.sch]
2017-03-06 Added dimensions to the pcb. Every little helps.
    [Circuit_Schematicv2.brd, Circuit_Schematicv2.sch]
2017-03-06 recent eagle changes
    [Circuit_Schematicv2.brd, Circuit_Schematicv2.sch]
2017-03-07 Finished the PCB board and schematic
    Changes might have to be made based on the testing on Friday the 10th
    March
    [Circuit_Schematicv2.brd, Circuit_Schematicv2.sch]
2017-03-09 ISSUE WITH STRING COMPARISON IN ESP CODE - WTF?!?!?!?!?
    [Receive-ESP.ino]
2017-03-09 Solved issue with esp code.
    [Receive-ESP.ino]
2017-03-10 finished the PCB
    [Circuit_Schematicv2.brd, Circuit_Schematicv2.sch]
2017-03-11 Final changes to make ESP work
    [Circuit_Schematicv2.brd, Circuit_Schematicv2.sch]
2017-03-11 Removed unnecessary switch that I put in on GPIO14
    [Circuit_Schematicv2.brd, Circuit_Schematicv2.sch]
2017-03-13 Updated circuit
2017-03-16 Modified circuit to include transistors
    [Circuit_Schematicv2.brd, Circuit_Schematicv2.sch]
2017-03-18 Final hardware changes and removed serial monitor from esp code in attempt to reduce noise
    [Circuit_Schematicv2.brd, Circuit_Schematicv2.sch]
2017-03-19 fixing the crapple
    [Circuit_Schematic.sch, Circuit_Schematicv2.brd, Circuit_Schematicv2.sch]
2017-03-20 Updated the PS for the PIC
    [Circuit_Schematicv2.brd, Circuit_Schematicv2.sch]
2017-03-20 Added GPIO jumpers instead of switches
    [Circuit_Schematicv2.brd, Circuit_Schematicv2.sch]
2017-03-20 Added a pull up resistor for data clock
    and capacitors for the power lines for AR1010
    [Circuit_Schematicv2.brd, Circuit_Schematicv2.sch]
2017-03-20 fixed the crappy issue
    If error comes up, delete all <<<< HEAD, ====== and all >>>>>
    [Circuit_Schematicv2.sch]
2017-03-20 Fixed Debounce and Long Press
    [fm.h, main.c]
2017-03-21 Added eprom code to the PIC
    [Circuit_Schematicv2.brd]
2017-03-21 Added new .brd file
    [Circuit_Schematicv2.brd]
2017-03-21 removed some circuit confusions
    [Circuit_Schematicv2.brd]
2017-03-21 Merge remote-tracking branch 'origin/master'
    # Conflicts:
    # .DS_Store
    # Schematics/Circuit_Schematicv2.b#1
    # Schematics/Circuit_Schematicv2.b#2
    # Schematics/Circuit_Schematicv2.b#3
    # Schematics/Circuit_Schematicv2.b#4
    # Schematics/Circuit_Schematicv2.b#5
    # Schematics/Circuit_Schematicv2.b#6
    # Schematics/Circuit_Schematicv2.b#8
    # Schematics/Circuit_Schematicv2.brd
    # Schematics/Circuit_Schematicv2.s#1
    # Schematics/Circuit_Schematicv2.s#4
    # Schematics/Circuit_Schematicv2.s#5
    # Schematics/Circuit_Schematicv2.s#6
    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
    [Circuit_Schematicv2.brd, Circuit_Schematicv2.sch]
2017-03-21 Completed the PCB design
    At the moment it’s 6mils! OOPS. Will try to do it with 10mils.
    [Circuit_Schematicv2.brd, Circuit_Schematicv2.sch]
2017-03-21 github is crazy
    [Circuit_Schematicv2.brd, Circuit_Schematicv2.sch]
2017-03-22 Fixed I think?
    # Schematics/Circuit_Schematicv2.s#8
    # Schematics/Circuit_Schematicv2.sch
    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
    [Circuit_Schematicv2.brd, Circuit_Schematicv2.sch]
2017-03-22 Finished the PCB design
    [Circuit_Schematicv2.brd, Circuit_Schematicv2.sch]
2017-03-24 Created GERBER Files and BOM
    [Circuit_Schematicv2.brd, Circuit_Schematicv2.sch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]
2017-04-05 made some pretty pics of circuit
2017-04-20 First terminal commit
    [fmproject14.GBL, fmproject14.GBO, fmproject14.GBP, fmproject14.GBS, fmproject14.GTL, fmproject14.GTO, fmproject14.GTP, fmproject14.GTS]
2017-04-21 Added Array of Buttons
2017-04-24 Added eeprom code that works!
    [fmproject14.GBL, fmproject14.GBO, fmproject14.GBP, fmproject14.GBS, fmproject14.GTL, fmproject14.GTO, fmproject14.GTP, fmproject14.GTS]
2017-05-07 the software is now clean. commented and invincable
    Added station names, fixed screen timer interupt bug, fixed debouce exit
    long press to short press, fixed timer overflow issue, removed fm.h and
    fm_readwite.h
    [eeprom.h, fm_functions.h, fm_readwrite.h, lcd.h, main.c]
2017-05-09 swapped the channel and volume buttons around
    also added some delays in initialisation.
    [main.c]
